liu369369/contest2026_443_fengxieke/hardware/fireeye_carrier_board_design.md

# 火眼 · 载板设计方案 v0.2

> 生成日期：2026-10-10 ｜ 修订：2026-10-11 ｜ 状态：设计输入已冻结，待评审
> 目标：为线下答辩提供一体化硬件载体（决赛打磨项）
> 关联：本文档只描述硬件；固件侧 INA228 驱动另见 `docs/`

### 修订记录

- **v0.8（2026-10-11）电源解耦完成 + R15 复原**：
  - 新增 `12V_IN` 网络：`DC 座(1脚) → U2 VIN / R9 EN上拉 / C10 输入电容`；
    `24V_P` 现在**只剩被测回路**（D1 阴极、R1 分流、R3 采样串阻）→ 板子自耗与测量彻底分离；
  - 12V 电池接口确定：**DC-005-5.5×2.1（即 DC5521）**，立创 **C9900017044**。
    注意：5.5×2.1 与 5.5×2.5 在立创库里**共用同一个封装**（`DC-IN-TH_DC-005-2`，footprintUuid 相同），
    所以板上焊盘一模一样、**PCB 不受影响**，区别只是塑料孔内径（2.1 / 2.5）——下单别买错；
    3 脚（开关脚）留空；
  - R15（19.1k，被误删）已复原并核验：`R15 1=GND 2=FB_NODE`；
  - 补充"上电前必须人工确认的 4 件事"，见 3.1 节末。
- **v0.7（2026-10-11）继电器改常开 + 补齐声光器件接线**：
  - 继电器由常闭改为**常开（NO）**：`COM(3) → NO(2) → LOAD_P`，NC 留空；**固件极性需反一次**；
  - 板载有源蜂鸣器 BUZZER1（TMB12A05，C96093）接线完成：1=5V、2=BUZZ_N；
  - 电源指示灯 LED1（5mm 翠绿，C52034719）+ U12（470Ω，C2907329）：VCC → U12 → LED1 → GND，常亮；
  - 外接报警灯模块座 U11（1×3，C54973828）：1=5V、2=GND、3=LED_CTRL；
  - 删除悬空的 R16（100k）。
- **v0.6（2026-10-11）按最新决定简化**：
  - **不加 3V3 LINK 跳线、不加保险丝**（用户决定）：载板 3.3V 直接经母座 JP6-2 给 START 板；
  - 网口按原接法保留（1=VCC 3.3V、2=5V、4=GND；6 条信号已接回主控）；
  - 继电器**维持常闭（NC）接法**，第 2 脚（NO）继续留空（失效安全讨论见 3.3，已知取舍）；
  - 蜂鸣器、报警 LED、绿色电源 LED 全部改为**板载**；删掉悬空的 R16。
- **v0.5（2026-10-11）按最新改动同步**：
  - 电池确认为**充放电双口**，充电口与放电口分开（无"带载充电"问题）；
  - W5500 座由 1×7 改为 **2×5（10 脚）**，补齐引脚定义，并把断开的 6 条信号网络接回主控；
  - 蜂鸣器、报警灯由"外接模块"改为**板载器件**（外壳需留声孔与灯孔）；
  - 记录继电器常闭/常开的失效安全讨论（见 3.3 待决策项）。
- **v0.4（2026-10-11）电源架构改为独立供电**：
  - 载板改用 **12V 锂电池**供电（DC 座进板 → 保险丝 → 防反接 → MP1584 → AMS1117），
    **24V 只作为被测回路**，与板子电源完全解耦；
  - 原「24V 自取电」方案作废（好处：板子自耗不进测量、可调电源电流显示与 INA228 读数一致）；
  - 主控供电采用 **3V3 LINK 跳线**：演示=载板供电（不插 USB），调试=插 USB 并拔跳线；
  - 补充电池充电、接口防呆、续航与安全口径，见 3.1 节。
- **v0.3（2026-10-11）按 EDA 网表复核结果修订**：
  - 新增 **6.5 节「母座引脚定义」**：从 START 板原理图逐脚实测出 JP5 / JP6 全部信号，
    并据此改正"JP5 侧有 GND 脚"这个错误说法（**JP5 的 38 脚全是 GPIO，没有任何电源脚**）；
  - 6.2 节 MP1584 补上第 9 脚（散热焊盘 EP）接 GND 的说明（原先误接 24V_P，已在 EDA 内改正）；
  - 3.1 节增加**待决策项**：载板 3.3V（网络名 VCC）与 START 板 3V3（JP6-2）并联的问题；
  - 9.3 节补上各接插件的立创编号（调试串口座实际是 **C18197979**，不是 C20363580）；
  - 原理图内已修复的缺陷（继电器驱动断线、23 组母座同号脚误连）记录在 `easyeda_progress.md`。
- **v0.2（2026-10-11）冲突清理**：
  - 地设计统一为**单一 GND**：删除 6.1 / 6.2 节的 GND_P / GND_S 分区写法，3.5 节相应改写；
  - 3.2 节功率路径补回漏画的 D1；
  - R_shunt 统一为 **2mΩ / 3W / 2512**（原写 2W）；
  - C1 / C2 统一为 **10µF / 50V**（原写 22µF/35V 与 22µF/16V）；
  - D1 统一为 **SS54 / SMA**（第 4 章原误写 SS34）；
  - 器件数由 Q1-Q3 改为 **Q1 / Q2**（报警灯直连，不用三极管）；
  - 蜂鸣器极性统一为**高电平导通**（原 3.3 节误写低电平触发）；
  - 注明 EDA 原理图中 3.3V 网络名为 `VCC`，与本文档的 `3V3` 是同一网络；
  - 6.4 节补充答辩口径提醒（1.75A 下的 ACS712 单码电流）。
  - **新增第十章「位号对照表」**：本文档位号与嘉立创 EDA 实际自动编号不一致，逐条列出对应关系
    （起因：EDA 网表复核发现 U1/U2/U3、R、C 的编号与本文档完全不同）。
- **v0.1（2026-10-10）**：初稿。

## 一、设计输入（冻结）

| 项 | 取值 | 备注 |
|---|---|---|
| MCU 子板 | GD32407V-START V1.1（板载 GD32F407VKT6） | 官方板，插在载板上 |
| 演示回路 | 24V DC / 1.75A | 可调电源 MN-605S + 灯泡假负载 |
| 断电机构 | 继电器 | 24V 低于触点 30VDC 额定 |
| 电流检测 | INA228 + 2mΩ 分流电阻 | 高端检测，共模 24V |
| 温度检测 | NTC 10K B3950 + 10k 分压 | 沿用现有方案 |
| 通信 | W5500 以太网 | 模块插接 |
| 显示 | SSD1306 OLED（I2C1） | 模块插接 |
| 载板供电 | **12V 锂电池 → DC 座 → MP1584(5V) → AMS1117(3.3V)** | 与 24V 被测回路完全独立 |
| 电池充电 | 电池另引 DC 母头到外壳外，用**配套的 12V 锂电充电器** | 充电回路不经过载板 |
| 外壳 | 挂壁式，3D 打印 | 已有打印机 |

## 二、机械定位（实测标定）

START 板外形 **60.0 x 95.0mm**。坐标以 START 板左上角为原点（x 向右、y 向下）。

| 项 | 数值 | 来源 |
|---|---|---|
| 板宽 x 板高 | 60.0 x 95.0mm | 实测 + 布局图标定（511px = 60mm） |
| JP6 母座中心线距左边缘 | 5.54mm | 塑壳外缘距板边 3mm + 塑壳半宽 2.54mm |
| JP6 两列焊盘中心线 | 距左边缘 4.27 / 6.81mm | 布局图像素测量 |
| JP5 母座中心线距右边缘 | 5.54mm | 与 JP6 对称 |
| 两母座中心距 | 48.92mm | 60 - 5.54 x 2 |
| 排针上端焊盘中心距板上边缘 | 30.0mm | 实测 2.9cm + 塑壳端偏移 1.27mm |
| 排针下端焊盘中心距板下边缘 | 19.3mm | 实测 1.8cm + 塑壳端偏移 1.27mm |
| 首末焊盘跨距 | 45.72mm | 18 x 2.54mm（自校验 30.0+45.72+19.3 = 95.0） |
| **第 1 脚方位** | **在排针下端** | 布局图丝印 PC7 = 第 38 脚，位于最上端 |

> 第 1 脚方位如果搞反，母座会整体反向 180 度，所有信号错位。已用布局图丝印交叉确认。

## 三、电路方案

### 3.1 电源树

> **2026-10-11 决策：载板独立供电。** 板子用 12V 锂电池供电，24V 只当被测回路。
> 好处是板子自耗完全不经过分流电阻，可调电源显示的电流与 INA228 读数一致（不必再解释几十 mA 自耗）。

```
【板子电源，与下面完全独立】
12V 锂电 → DC 座 J3 →（D4 防反接，可选）→ U1 MP1584EN (12V→5V)
                                                  ├─ 继电器线圈 / 蜂鸣器 / 报警灯（5V）
                                                  └─ U2 AMS1117-3.3 (5V→3.3V)
                                                        ├─ INA228 / OLED / W5500 / I2C 上拉
                                                        └─ 母座 JP6-2（经 3V3 LINK 跳线）→ START 板 3V3

【被测回路】
24V 端子 J1 → F1 → D1 → R1(2mΩ) → 继电器 COM→NC → J2 → 负载 → 回 GND
```

- 12V 输入对 MP1584（4.5-28V）**余量充足**，不再是 24V 那种贴着上限的状态。
- **主控供电（2026-10-11 决定：不加跳线）**：载板 3.3V 直接经母座 JP6-2 送到 START 板 3V3。
  - **演示**：只给 12V 电池，不插 USB。
  - **调试**：插 USB 时把 12V 电池的 DC 座拔掉 —— START 板的 LDO 会顺带把载板 3.3V 反灌供起来，
    逻辑（INA228 / OLED / 网口）能跑；但 5V 那一路没有，**继电器不吸合、蜂鸣器和灯不动作**，
    要测声光报警还是得给 12V。
  - 已知取舍：**12V 电池和 USB 同时插时，两片 AMS1117 输出对顶**（还可能顺着 START 板 LDO 往 USB 的 VBUS 倒灌）。
    现场别这么用；真要同时用，就回到"加跳线"的方案。
- 载板经 JP6-2 给 START 板供电时，还要带上板载 GD-Link（GD32F103，约 20~30mA）；
  AMS1117（1A）与 MP1584（3A）都绰绰有余。
- 外设一律走载板自供电：START 板 3V3 那条路受板上 500mA 自恢复保险丝限制，不要在它上面挂外设。
- **电池与充电（安全底线）**：（电池为**充放电双口**，2026-10-11 确认，充电口与放电口分开）
  - 12V 锂电必须用**配套的专用充电器**充（3S 锂离子满电 12.6V，12V LiFePO4 满电 14.6V），
    **绝对不能用普通 12V 电源适配器直接充**——本作品要防的就是过充，方案里不能自己踩这个坑。
  - 充电口（DC 母头）装在外壳外面，充电回路**不经过载板**。
  - **保险丝按 2026-10-11 决定不加**：依赖电池包自带 BMS 的短路保护。若后面想补，电池正极就近串一个
    0.5~1A 自恢复保险丝即可（PCB 上留两个焊盘位置更省事）。
  - 续航估算：载板+主控约 160mA@12V（继电器常励磁占大头），3Ah 的 12V 包约能撑 18 小时，答辩够用。
  - 建议同时准备一个 12V 适配器当现场备用（接口与充电口区分开，别混插）。
- 原「24V 自取电」方案作废（历史记录保留在 v0.2/v0.3 的修订说明里）。

**上电前必须人工确认的 4 件事**（板上没有提示，靠万用表和模块丝印）：

1. **DC 座极性**：万用表通断档，一支表笔插进座的中心孔，另一支分别碰 1 / 2 / 3 脚焊盘，
   确认哪个焊盘是中心针。现按 `1 脚 = 12V_IN`、`2 脚 = GND` 接；**3 脚是开关脚，留空，不要接地**
   （把开关脚接地，没插插头时会把正负极短起来）。
2. **网口模块**：现在 1 脚(3.3V) 和 2 脚(5V) 都接了。确认模块是不是"5V 进、自带 LDO"的版本——
   如果是，建议把 1 脚断开，否则模块自己的 LDO 与载板 3.3V 会对顶。
3. **报警灯模块座 U11（1×3）**：现接 `1=GND、2=5V、3=LED_CTRL`，按模块丝印核对顺序。
4. **蜂鸣器极性**：现接 `1=5V、2=BUZZ_N`；若实物 "+" 在另一脚，两根线对调即可（接反只会不响，不烧）。

### 3.2 电流检测（INA228）

| 元件 | 参数 | 说明 |
|---|---|---|
| R_shunt | 2mΩ / 3W / 2512 | 5A 时压降 10mV、耗散 50mW（实物 LMN25HF3P0R002S，C41406285） |
| U3 | INA228AIDGSR（VSSOP-10） | 85V 共模，20 位 ΔΣ |
| 输入滤波 | 2 x 10Ω + 100nF 差分 + 10nF 对地 | 截止约 160kHz |
| I2C 上拉 | 4.7kΩ x 2 -> 3.3V | 与 OLED 共用 I2C1，不冲突 |
| 地址 | A0/A1 接地 | 0x40（OLED 0x3C） |
| ADC 量程 | VSHUNT = ±40.96mV | 对应 ±20.5A，LSB 约 0.039mA |

**功率路径**（分流电阻放在最前，共模恒定）：

```
J1(24V+) -> F1 -> D1 -> R_shunt -> K1(COM->NC) -> J2(负载+) -> 负载 -> J2(负载-) -> 电源 -
```

分流电阻紧贴电源侧，即使继电器断开，INA228 的共模也稳定在 24V。

### 3.3 断电与输出驱动

| 通道 | 器件 | 驱动方式 | 极性 |
|---|---|---|---|
| 继电器 K1 | 5V 线圈，1 组转换（等效 JQC-3FF-S-Z） | NPN S8050 + 1kΩ 基极 + 10kΩ 下拉 + 1N4148 续流 | 高电平吸合（**需重新定标**） |
| 蜂鸣器 | 有源蜂鸣器 | NPN S8050 + 1kΩ 基极 + 10kΩ 下拉 | **高电平导通**（改为低边驱动，与原方案相反，宏需反转） |
| 报警灯 | LED 模块信号脚（模块自带驱动） | 直连排针，不加三极管 | 高电平触发（沿用） |

> **重要**：由"裸器件直连"改为"三极管驱动"会改变触发极性。固件中的
> `FIREEYE_RELAY_ACTIVE_LOW`、`FIREEYE_BUZZER_ACTIVE_HIGH`、`FIREEYE_LED_ACTIVE_HIGH`
> 三个宏必须上板实测后重新定标，不可沿用旧值。

> **已决定（2026-10-11）：继电器改用常开（NO）接法**（原为常闭，按保护逻辑改过来）。
> 接法为 `COM(3) → NO(2) → LOAD_P`，NC(5) 留空：**励磁才导通；掉电、复位、报警都会自动断开负载**。
> - 这才是保护类设备真正意义上的"失效安全"：板子死机或断电时负载被切断。
> - **固件极性要反一次**：原先是"报警→吸合（断开）"，现在是"正常→吸合（导通）、报警→释放（断开）"。
>   应用层的 `gd32_fireeye_set_relay(true/false)` 语义不变（`true`=断开负载、`false`=恢复），
>   只需要把**板级实现里的 GPIO 电平映射反过来**。
> - 正常充电时线圈常励磁 71mA（耗电与之前报警后相同），报警后线圈释放、反而更省电。

### 3.4 接口定义

| 接口 | 形式 | 信号 |
|---|---|---|
| START 板母座 | 2 x (2x19) 母座，2.54mm | JP5 / JP6 全引出 |
| 24V 输入 | 2 位螺丝端子 5.08mm | 电源进 |
| 负载输出 | 2 位螺丝端子 5.08mm | 24V 回路出 |
| OLED | 4 pin 排针 | GND / 3V3 / SCL(PB10) / SDA(PB11) |
| W5500 | **2×5（10 脚）排针座** | 1=VCC(3.3V)、2=5V、3=MISO、4=GND、5=MOSI、6=RST、7=SCS、8=INT、9=SCLK、10=NC（2026-10-11 决定：按现状保留） |
| 温度 | 2 pin 端子 | NTC 分压中点 -> PA6 |
| 调试串口 | 3 pin 排针 | PB6(TX) / PB7(RX) / GND |

> 母座 JP5 / JP6 的**逐脚定义**见 6.5 节（实测自 START 板原理图）。

### 3.5 采样抗干扰（解决电流检测偏差的关键）

原实测问题：继电器线圈 70mA 与传感器共用供/地路径，产生约 1.12A 的假底数（改线后残留 0.12A）。

载板对策（**最终版本见第八章 8.5，本节只列结论**）：

1. **单一地**：全板只用**一个 GND 网络**，不做 GND_P / GND_S 分割（理由见第八章）；
2. **开尔文接法**：INA228 的 IN+/IN- 从分流电阻焊盘内侧取样，走等长差分对；
3. **回流路径在布局层面分离**：继电器线圈、蜂鸣器、报警灯的回流走板下区，不横穿采样区、不与差分对平行；
4. **功率与信号分区**：24V/2A 大电流路径走板的一侧，信号走另一侧，中间用地铜隔离。

## 四、BOM 概览

| 位号 | 器件 | 封装 | 数量 | 参考价 |
|---|---|---|---|---|
| U1 | MP1584EN（商城件 C2916141 标注 MP1584WN） | ESOP-8 | 1 | 2 元 |
| U2 | AMS1117-3.3 | SOT-223 | 1 | 0.3 元 |
| U3 | INA228AIDGSR | VSSOP-10 | 1 | 20 元 |
| R_shunt | 2mΩ 3W | 2512 | 1 | 1 元 |
| K1 | 继电器 5V | DIP | 1 | 3 元 |
| Q1/Q2 | S8050 | SOT-23 | 2 | 0.3 元 |
| F1 | 自恢复保险丝 2A | 1812 | 1 | 0.5 元 |
| D1 | SS54 | SMA | 1 | 0.3 元 |
| J1/J2 | 螺丝端子 5.08mm | THT | 2 | 2 元 |
| — | 2x19 母座 2.54mm | THT | 2 | 2 元 |

## 五、已确认项（2026-10-10）

1. ACS712 对比接口：**不留**
2. 万用表：现有三位半（实验方案见 6.4）
3. 继电器：**板载直插**
4. 连接方式：START 板**直接插在载板上**（插接式）
5. 外壳内部布局与开孔朝向：待定

## 六、网表级连接表

> 说明：IC 的引脚号请以厂商 datasheet 为准，下表按**信号名**连接。
> 本章位号是本文档自定义编号，与 EDA 实际位号不同，对照表见第十章。

### 6.1 网络定义

| 网络 | 类别 | 说明 |
|---|---|---|
| 24V_IN | 功率 | 端子 J1-1 出来、保险丝之前 |
| 24V_F | 功率 | 保险丝之后、防反接之前 |
| 24V_P | 功率 | 防反接之后（保护后） |
| 24V_SW | 功率 | 分流电阻之后、继电器 COM 之前 |
| LOAD_P | 功率 | 继电器 NC 之后、去负载端子 |
| GND | 地 | **全板单一地网络**：负载回流、继电器/蜂鸣器/报警灯回流与 INA228、MCU、I2C、OLED、W5500、LDO 共用（最终决定见第八章） |
| 5V | 电源 | DC-DC 输出 |
| 3V3 | 电源 | LDO 输出（**EDA 原理图中该网络名为 `VCC`**，两者是同一网络） |

> **本节早先的 GND_P / GND_S 分区写法已作废**：本章其余条目里出现的 GND_P / GND_S 一律按 GND 理解。
> 改为单一地的理由见第八章开头；继电器线圈的 70mA 靠**布局避让**隔离（8.5 第 9 条），而不是靠分割地。

### 6.2 元件连接

**J1（24V 输入端子，2P）**
- 1 -> 24V_IN
- 2 -> GND（负载回流与信号地的唯一汇合点，全板地参考点）

**F1（自恢复保险丝 2A）**
- 1 -> 24V_IN
- 2 -> 24V_F

**D1（防反接 SS54）**
- 阳极 -> 24V_F
- 阴极 -> 24V_P
- 压降约 0.45V@2A，位于分流电阻之前，不影响电流测量

**R1（分流电阻 2mΩ / 3W / 2512）**
- 1 -> 24V_P
- 2 -> 24V_SW
- 开尔文取样：INA228 的 IN+ 从 R1-1 内侧取、IN- 从 R1-2 内侧取

**K1（5V 继电器，板载直插）**
- 线圈+ -> 5V
- 线圈- -> Q1 集电极
- COM -> 24V_SW
- NO -> LOAD_P（励磁才导通；报警/掉电/复位即断开）
- NC -> 悬空（未使用）

**J2（负载输出端子，2P）**
- 1 -> LOAD_P
- 2 -> GND

**U1（MP1584EN，24V -> 5V）**
- IN -> 24V_P
- EN -> 100kΩ 上拉到 IN
- BST -> 100nF -> SW
- SW -> L1 47µH -> 5V；SS34 续流二极管（阴极接 SW、阳极接 GND）
- FB -> 分压 R_fb1 = 100kΩ（FB 到 5V）/ R_fb2 = 19.1kΩ（FB 到 GND），约 5.0V
- COMP -> 3.3nF + 6.8kΩ 串联到 GND
- FREQ -> 100kΩ 到 GND（约 500kHz）
- GND -> GND
- **第 9 脚（散热焊盘 EP）-> GND**：立创库符号把第 9 脚标成 `EN`，但封装实际是 `SOIC-8-EP`，
  按 datasheet 散热焊盘应接 GND（原先误接 24V_P，已在 EDA 内改正）

**U2（AMS1117-3.3）**
- IN -> 5V（10µF 到 GND）
- OUT -> 3V3（10µF 到 GND）
- GND -> GND

**U3（INA228）**
- VS -> 3V3
- GND -> GND
- IN+ -> R1-1（串 10Ω）
- IN- -> R1-2（串 10Ω）
- 差分滤波：100nF 跨 IN+/IN-，10nF 分别对 GND
- VBUS -> 24V_SW（顺带测供电电压）
- SCL -> I2C1_SCL
- SDA -> I2C1_SDA
- A0 / A1 -> GND（地址 0x40）
- ALERT -> 悬空
- 上拉：I2C1_SCL、I2C1_SDA 各 4.7kΩ 到 3V3

**Q1（继电器驱动，S8050）**
- 基极 -> 1kΩ -> START-PB0
- 基极 -> 10kΩ 下拉到 GND
- 发射极 -> GND
- 集电极 -> K1 线圈-
- D2（1N4148）跨线圈：阴极接 5V、阳极接 Q1 集电极
- 极性：PB0 高电平吸合（与原方案一致）

**Q2（蜂鸣器驱动，S8050）**
- 基极 -> 1kΩ -> START-PB1
- 基极 -> 10kΩ 下拉到 GND
- 发射极 -> GND
- 集电极 -> 蜂鸣器-
- 蜂鸣器+ -> 5V
- 极性：PB1 高电平导通（**与原方案相反，宏需反转**）

**报警灯（3 pin 排针，直连不加驱动）**
- VCC -> 5V
- GND -> GND
- SIG -> START-PD9
- 极性：保持不变（原模块即为高电平触发）

**NTC 分压**
- 3V3 -> 10kΩ -> 节点 -> NTC -> GND
- 节点 -> START-PA6
- 节点可加 100nF 到 GND 去抖

**OLED 座（4 pin，顺序以实际模块丝印为准）**
- GND -> GND
- VCC -> 3V3
- SCL -> I2C1_SCL（START-PB10）
- SDA -> I2C1_SDA（START-PB11）

**W5500 座**
- SCLK -> START-PB13
- MISO -> START-PB14
- MOSI -> START-PB15
- SCS -> START-PE7
- RST -> START-PE9
- INT -> START-PE11
- 3V3 -> 3V3
- GND -> GND

**调试串口（3 pin）**
- TX -> START-PB6
- RX -> START-PB7
- GND -> GND

**START 板母座（2 x 2x19）**
- 仅连接上表用到的引脚，其余悬空
- 机械定位见第二章

### 6.3 固件需要同步的改动

| 项 | 原值 | 载板上的新值 |
|---|---|---|
| FIREEYE_RELAY_ACTIVE_LOW | 0 | **要反一次**（改用 NO 后：报警时继电器释放；具体填 0 还是 1 按该宏在代码里的定义确认） |
| FIREEYE_BUZZER_ACTIVE_HIGH | 0 | **1**（NPN 低边驱动改为高电平有效） |
| FIREEYE_LED_ACTIVE_HIGH | 1 | 1（不变） |
| 电流读取 | ADC 采 PA4 | **INA228 走 I2C1（需新写驱动）** |
| 温度读取 | ADC 采 PA6 | 不变 |

> 三个极性宏的最终值必须**上板实测**后确认，不要照抄此表。

### 6.4 精度实验方案（三位半万用表的限制）

三位半万用表直流电流档典型精度为 ±(1.0%+2 字)、2A 档分辨率 1mA，
而 INA228 的目标精度优于 ±0.5%。**拿它当标定基准是非对称的，不做绝对精度对比。**

改用两条可执行的路线：

1. **读数抖动对比**（主推，不需要外部标准）：同一电流工况下各采 60 秒，
   分别统计旧方案（ACS712）与新方案（INA228）读数的标准差与峰峰值，
   结论写成"读数波动从 ±xx mA 降到 ±x mA"。这是自比较，不受万用表精度影响。
2. **量级核对**（辅助）：用万用表确认电流大致在设定值附近（如设定 1.75A、实测 1.7~1.8A），
   只用于证明"量级正确"，不声明精度。

如果后续能借到四位半万用表，再补做"设定值 vs 读数"的线性度曲线。

> **答辩口径提醒**：旧方案"读数只有 6~7 个 ADC 码"的论证基于 **0.15A** 的老负载；
> 现在演示电流是 **24V / 1.75A**，同样条件下 ACS712 有约 71 个码。答辩时不要沿用"6~7 个码"的说法，
> 统一按 1.75A 口径：ACS712 单码 ≈ 24mA，INA228 单码 ≈ 0.039mA（约 625 倍差距）。
> 造成旧方案"实测 1.12A 假底数"的地线耦合问题与负载大小无关，这条论据可以继续用。

### 6.5 母座引脚定义（实测自 START 板原理图）

来源：`GD32F470V-START-V1.0.pdf` 第 1 页（Extension），按图纸坐标逐脚取出，非推测。

**JP6（EDA 位号 U5）**：1 脚、3 脚 = GND，2 脚 = +3V3，其余 35 脚为 GPIO。

| 脚 | 信号 | 脚 | 信号 | 脚 | 信号 | 脚 | 信号 |
|---|---|---|---|---|---|---|---|
| 1 | GND | 11 | PB9 | 21 | PD4 | 31 | PA14 |
| 2 | +3V3 | 12 | PE0 | 22 | PD5 | 32 | PA13 |
| 3 | GND | 13 | PB7 | 23 | PD3 | 33 | PA10 |
| 4 | PC13 | 14 | PB8 | 24 | PD2 | 34 | PA9 |
| 5 | PE5 | 15 | PB5 | 25 | PD1 | 35 | PA8 |
| 6 | PE6 | 16 | PB6 | 26 | PD0 | 36 | PC9 |
| 7 | PE3 | 17 | PB3 | 27 | PC12 | 37 | PC8 |
| 8 | PE4 | 18 | PB4 | 28 | PC11 | 38 | PC7 |
| 9 | PE1 | 19 | PD6 | 29 | PC10 | | |
| 10 | PE2 | 20 | PD7 | 30 | PA15 | | |

**JP5（EDA 位号 U6）**：38 脚**全部是 GPIO，没有任何 GND / 3V3 脚**。

| 脚 | 信号 | 脚 | 信号 | 脚 | 信号 | 脚 | 信号 |
|---|---|---|---|---|---|---|---|
| 1 | PC1 | 11 | PC4 | 21 | PE13 | 31 | PD9 |
| 2 | PC0 | 12 | PA7 | 22 | PE12 | 32 | PD8 |
| 3 | PC3 | 13 | PB0 | 23 | PE15 | 33 | PD11 |
| 4 | PC2 | 14 | PC5 | 24 | PE14 | 34 | PD10 |
| 5 | PA2 | 15 | PE7 | 25 | PB11 | 35 | PD13 |
| 6 | PA1 | 16 | PB1 | 26 | PB10 | 36 | PD12 |
| 7 | PA4 | 17 | PE9 | 27 | PB13 | 37 | PD15 |
| 8 | PA3 | 18 | PE8 | 28 | PB12 | 38 | PD14 |
| 9 | PA6 | 19 | PE11 | 29 | PB15 | | |
| 10 | PA5 | 20 | PE10 | 30 | PB14 | | |

**载板用到的 JP5 脚（逐条与信号名核对一致）**

| 脚 | 信号 | 载板网络 | 脚 | 信号 | 载板网络 |
|---|---|---|---|---|---|
| 9 | PA6 | NTC_ADC | 25 | PB11 | I2C1_SDA |
| 13 | PB0 | RELAY_CTRL | 26 | PB10 | I2C1_SCL |
| 15 | PE7 | W5500_SCS | 27 | PB13 | SPI1_SCK |
| 16 | PB1 | BUZZ_CTRL | 29 | PB15 | SPI1_MOSI |
| 17 | PE9 | W5500_RST | 30 | PB14 | SPI1_MISO |
| 19 | PE11 | W5500_INT | 31 | PD9 | LED_CTRL |

**载板用到的 JP6 脚**：1 / 3 = GND，2 = +3V3（**注意 3.1 节的待决策项**），13 = PB7 = UART_RX，16 = PB6 = UART_TX。

> **踩坑记录**：JP5 的 PD9/PD8/PD11/PD10/PD13/PD12/PD15/PD14 与 JP6 的 PA13/PA14（SWD 调试口）等脚
> **物理脚号相同**。早期在 EDA 里把脚号直接当网络标签用，结果 JP5 与 JP6 的同号脚被连成 23 个网络
> （其中一对是 PA13=SWDIO），已于 2026-10-11 改名为 `JP5_n` / `JP6_n` 消除。

## 七、载板布局（v0.3）

### 7.1 尺寸与模块实测

| 对象 | 尺寸 | 备注 |
|---|---|---|
| 载板 | **105 x 140mm** | 用户确定 |
| START 板 | 60 x 95mm | GD32407V-START V1.1 |
| W5500 模块 | 28 x 55mm | 含 RJ45 座，7 pin 排针 |
| OLED 模块 | 26.92 x 27.35mm | 安装孔距 23.34 x 23.81mm，孔径 2.5mm |

### 7.2 分区

坐标原点为载板左上角，x 向右、y 向下。

| 区 | 范围 | 内容 |
|---|---|---|
| 左区 | x 0-40mm | 上：OLED 座（y 14-41）；下：W5500 座（y 85-140，RJ45 朝下、模块下端与载板下边缘齐平，网线从板下方出） |
| 右区 | x 40-100mm, y 10-105mm | START 板覆盖区。板下净空约 8.5mm，只放贴片元件（DC-DC / LDO / 三极管驱动） |
| 下区 | y 105-140mm | 功率路径集中区：J1、F1、D1、R_shunt、INA228、继电器 K1、J2 |
| 边距 | 四周约 5mm | 板框、安装孔、丝印 |

功率路径集中在下方一横条，J1 -> 分流 -> 继电器 -> J2 的走线最短，便于做星形接地。

### 7.3 母座定位（载板坐标）

START 板左上角位于载板 (40, 10)。

| 项 | 坐标 |
|---|---|
| JP6 两列焊盘中心线 | x = 44.27 / 46.81mm |
| JP5 两列焊盘中心线 | x = 93.19 / 95.73mm |
| 两母座中心距 | 48.92mm |
| 第 38 脚（排针上端）焊盘中心 | y = 40.0mm |
| 第 1 脚（排针下端）焊盘中心 | y = 85.72mm |
| 首末焊盘跨距 | 45.72mm（18 x 2.54） |

> **第 1 脚在下端**。母座引脚号必须从下往上数，装反则全部信号错位。

### 7.4 布局说明与待定

- 下区（y 105-140）放 J1、J2、继电器、R_shunt + INA228，x 方向从 36mm 起，避开 W5500 的 RJ45 出线路径；
  DC-DC、LDO、三极管驱动全部放在 START 板下方的贴片区（虚线框 x 45-95, y 45-100）。
- W5500 现按 **RJ45 朝下** 设计。若改为朝左出线，左区需加宽到 55mm，载板宽改为 120mm。
- START 板四角固定方式（铜柱 + 螺丝，需在载板打对应安装孔）待定。

## 八、网表（按网络索引，最终版）

> **读表前必看**：本章及第九章的位号（U1/U2/U3、R1-R15、C1-C11、K1、L1、J1/J2、JP5/JP6）
> 是本文档自定义的编号；**嘉立创 EDA 里实际是另一套自动编号**。
> 两套编号的对照表见第十章，PCB / 贴片 / 飞线一律以 EDA 的位号为准。

> **地设计的最终决定：采用单一 GND 网络。**
> 理由：更换 INA228 后电流测量为差分输入 + 数字输出，CMRR 高于 100dB，
> 地线压降经开尔文连接后不进入测量结果。前文 6.1/6.2 中的 GND_P / GND_S 统一并入 GND。
> 抗干扰的重点因此从"分区接地"转移到"开尔文连接 + 布局避让"，见 8.5。

### 8.1 元件编号约定

| 位号 | 器件 | 位号 | 器件 |
|---|---|---|---|
| J1 | 24V 输入端子 | J2 | 负载输出端子 |
| F1 | 自恢复保险丝 | K1 | 继电器（5V 线圈） |
| D1 | 防反接 SS54 | D2 | 线圈续流 1N4148 |
| D3 | DC-DC 续流 SS34 | L1 | 47µH 功率电感 |
| U1 | MP1584EN | U2 | AMS1117-3.3 |
| U3 | INA228 | Q1/Q2 | S8050 |
| R1 | 分流电阻 2mΩ/3W | R2/R3 | INA228 输入串阻 10Ω |
| R4/R5 | I2C 上拉 4.7kΩ | R6/R7 | 继电器基极 1kΩ / 下拉 10kΩ |
| R8/R9 | 蜂鸣器基极 1kΩ / 下拉 10kΩ | R10 | NTC 分压 10kΩ |
| R11/R12 | FB 分压 100kΩ / 19.1kΩ | R13/R14 | COMP 6.8kΩ / FREQ 100kΩ |
| R15 | EN 上拉 100kΩ | C1/C2 | 输入 / 输出各 10µF/50V（无极性陶瓷） |
| C3 | 差分滤波 100nF | C4/C5 | 共模 10nF |
| C6 | INA228 去耦 100nF | C7/C8 | LDO 输入/输出 10µF |
| C9 | BST 100nF | C10 | COMP 3.3nF |
| C11 | NTC 滤波 100nF | | |

### 8.2 功率与电源网络

| 网络 | 连接点 |
|---|---|
| 24V_IN | J1-1, F1-1 |
| 24V_F | F1-2, D1-A |
| 12V_IN | DC 座-1, U1-IN, R15-1, C1(+)（12V 电池进板，与 24V 回路无关） |
| 24V_P | D1-K, R1-1, R3-1（**只含被测回路**，板子自耗已移出） |
| 24V_SW | R1-2, K1-COM, U3-VBUS |
| LOAD_P | K1-NC, J2-1 |
| 5V | L1-2, C2(+), U2-IN, C7(+), K1 线圈+, 蜂鸣器+, 报警灯 VCC, R11-2, U1-FB 分压上端 |
| 3V3 | U2-OUT, C8(+), U3-VS, C6-1, OLED-VCC, W5500-3V3, R4-2, R5-2, R10-1（**EDA 原理图中该网络名为 VCC**） |
| GND | J1-2, J2-2, C1(-), C2(-), D3-A, U1-GND, R12-2, R14-2, C10(经 R13), U2-GND, C7(-), C8(-), U3-GND, C4-2, C5-2, C6-2, Q1-E, Q2-E, 报警灯 GND, OLED-GND, W5500-GND, 串口 GND, NTC 下端, R7-2, R9-2, 母座 JP6(U5)-1 与 JP6(U5)-3（**JP5 侧没有任何 GND 脚**，见 6.5） |

**DC-DC 外围（U1 / MP1584EN，24V -> 5V）**

| 网络 | 连接点 |
|---|---|
| U1-BST | C9-1 |
| U1-SW | C9-2, L1-1, D3-K |
| D3-A | GND |
| U1-FB | R11-1, R12-1 |
| U1-COMP | C10-1（C10-2 -> R13-1，R13-2 -> GND） |
| U1-FREQ | R14-1（R14-2 -> GND） |
| U1-EN | R15-1（R15-2 -> 24V_P） |
| U1-IN | C1(+)，C1(-) -> GND |

> **C1 / C2 说明**：实物件是 10µF/50V 1206 陶瓷电容（**无极性**），表中 C1(+) / C1(-) 、C2(+) / C2(-)
> 只表示"接 24V_P 的一端 / 接 GND 的一端"，不是电解电容的极性标记。

### 8.3 电流检测网络（INA228）

| 网络 | 连接点 |
|---|---|
| INA_INP | R1-1, R2-1 |
| INA_INM | R1-2, R3-1 |
| INA_INP_F | R2-2, U3-IN+, C3-1, C4-1 |
| INA_INM_F | R3-2, U3-IN-, C3-2, C5-1 |
| C4-2 / C5-2 | GND |
| U3-VBUS | 24V_SW |
| U3-SCL | I2C1_SCL |
| U3-SDA | I2C1_SDA |
| U3-A0 / U3-A1 | GND（地址 0x40） |
| U3-ALERT | 悬空 |
| U3-VS | 3V3（就近 100nF + 1µF 到 GND） |

### 8.4 驱动、通信与外设

| 网络 | 连接点 |
|---|---|
| RELAY_CTRL | 母座 PB0 脚（JP5-13）, R6-1 |
| RELAY_DRV | R6-2, Q1-B, R7-1 |
| RELAY_COIL_N | Q1-C, K1 线圈-, D2-A |
| D2-K | 5V |
| BUZZ_CTRL | 母座 PB1 脚（JP5-16）, R8-1 |
| BUZZ_DRV | R8-2, Q2-B, R9-1 |
| BUZZ_N | Q2-C, BUZZER1-2（板载有源蜂鸣器 TMB12A05，正极接 5V） |
| LED_CTRL | 母座 PD9 脚（JP5-31）, U11-3（外接报警灯模块 SIG） |
| $1N239（内部网络） | U12-2, LED1-1 —— 电源指示灯支路中间点，仅这两点相连 |
| NTC_ADC | 母座 PA6 脚（JP5-9）, R10-2, NTC 上端, C11-1 |
| C11-2 | GND |
| I2C1_SCL | 母座 PB10 脚（JP5-26）, OLED-SCL, U3-SCL, R4-1 |
| I2C1_SDA | 母座 PB11 脚（JP5-25）, OLED-SDA, U3-SDA, R5-1 |
| SPI1_SCK | 母座 PB13 脚（JP5-27）, W5500-SCLK |
| SPI1_MISO | 母座 PB14 脚（JP5-30）, W5500-MISO |
| SPI1_MOSI | 母座 PB15 脚（JP5-29）, W5500-MOSI |
| W5500_SCS | 母座 PE7 脚（JP5-15）, W5500-SCS |
| W5500_RST | 母座 PE9 脚（JP5-17）, W5500-RST |
| W5500_INT | 母座 PE11 脚（JP5-19）, W5500-INT |
| UART_TX | 母座 PB6 脚（JP6-16）, 调试串口 TX |
| UART_RX | 母座 PB7 脚（JP6-13）, 调试串口 RX |

### 8.5 抗干扰设计要点

**采样链路（最关键）**

1. **开尔文连接**：R2 / R3 从 R1 的焊盘**内侧**引出，不借用功率走线；这是消除走线电阻误差的根本手段。
2. **差分对**：INA_INP / INA_INM 两条线等长、平行、间距固定、面积最小；中途不换层、不打过孔（必须换层时两条线一起换）。
3. **滤波就近**：C3（100nF 差分）与 C4/C5（10nF 共模）紧贴 U3 的输入脚，走线总长控制在 10mm 内。
4. **避让**：差分对与 SW 节点、L1、继电器线圈回路的间距不小于 5mm，且不平行走线。

**开关电源**

5. **SW 节点面积最小化**：这是最强的辐射源，铜箔面积越小越好，且不引长线。
6. **紧贴布局**：C1 贴 U1-IN、L1 与 C2 贴 U1-SW，回路面积最小。
7. **远离敏感区**：L1 与 U3、NTC 分压、I2C 走线的距离尽量远。

**继电器与感性负载**

8. **续流二极管紧贴线圈**：D2 到线圈两端的走线尽量短，抑制断开瞬间的反向尖峰。
9. **线圈回流路径**：5V -> 线圈 -> Q1 -> GND 这条回路走板下区，**不穿过采样区**，也不与差分对平行。
10. **可选 RC 吸收**：若断开时仍有尖峰影响，可在线圈两端并联 100Ω + 100nF。

**通信与数字**

11. **I2C**：4.7kΩ 上拉；走线远离 SW 与线圈；若有振铃可串 33Ω。
12. **SPI**：W5500 的四条线走短线，不跨分割区，不与差分对平行；必要时串 22-33Ω。
13. **去耦**：每个 IC 的电源脚就近放 100nF；U1 输入 10µF + 100nF；U2 输入/输出各 10µF。

**结构与外壳**

14. OLED 与 RJ45 的排线在载板边缘就近引出，避免长距离绕行；OLED 的 I2C 排线远离功率走线。
15. 功率区（下区）与信号区（左区、板下贴片区）在各层做物理分隔。

## 九、元件清单与封装（画图用）

> 用于在嘉立创 EDA 中放元件。封装按贴片优先（载板下方净空 8.5mm，贴片更稳妥）。
> 型号为常见市售型号，具体以下单时商城库存为准。
> 各器件的立创商城编号（C 开头）见 `easyeda_progress.md` 的已放置元件表。

### 9.1 有源器件

| 位号 | 器件 | 参数 | 封装 | 常见型号 | 数量 |
|---|---|---|---|---|---|
| U1 | 降压 DC-DC | 24V -> 5V / 3A | ESOP-8 | MP1584EN（C2916141，商城标注 MP1584WN） | 1 |
| U2 | LDO | 5V -> 3.3V / 1A | SOT-223 | AMS1117-3.3 | 1 |
| U3 | 电流/电压监测 | 20 位 ΔΣ，I2C | VSSOP-10 | INA228AIDGSR | 1 |
| Q1 | NPN 三极管 | 继电器驱动 | SOT-23 | S8050 | 1 |
| Q2 | NPN 三极管 | 蜂鸣器驱动 | SOT-23 | S8050 | 1 |
| D1 | 肖特基 | 防反接 5A/40V | SMA | SS54（C22452） | 1 |
| D2 | 开关二极管 | 线圈续流 | SOD-123 | 1N4148 | 1 |
| D3 | 肖特基 | DC-DC 续流 3A/40V | SMA | SS34 | 1 |
| K1 | 继电器 | 5V 线圈，1 组转换 | DIP（直插） | SRD-05VDC-SL-C / JQC-3FF-S-Z | 1 |
| F1 | 自恢复保险丝 | 2A | 1812 | 1812L200/36GR（C49196649） | 1 |

### 9.2 无源器件

| 位号 | 参数 | 封装 | 数量 |
|---|---|---|---|
| R1 | 2mΩ / 3W 合金电阻 | 2512 | 1 |
| R2, R3 | 10Ω | 0603 | 2 |
| R4, R5 | 4.7kΩ | 0603 | 2 |
| R6, R8 | 1kΩ | 0603 | 2 |
| R7, R9, R10 | 10kΩ | 0603 | 3 |
| R11, R14, R15 | 100kΩ | 0603 | 3 |
| R12 | 19.1kΩ | 0603 | 1 |
| R13 | 6.8kΩ | 0603 | 1 |
| C1 | 10µF / 50V（**耐压必须 ≥35V**） | 1206 | 1 |
| C2 | 10µF / 50V | 1206 | 1 |
| C3, C6, C9, C11 | 100nF | 0603 | 4 |
| C4, C5 | 10nF | 0603 | 2 |
| C7, C8 | 10µF / 16V | 0805 | 2 |
| C10 | 3.3nF | 0603 | 1 |
| L1 | 47µH 功率电感 | CD54 或 CDRH | 1 |
| NTC | 10K B3950 | 直插或贴片 | 1 |

### 9.3 接插件

| 本文档位号 | EDA 位号 | 器件与立创编号 | 备注 |
|---|---|---|---|
| J1 | U7 | 24V 输入端子 KF128-5.08-2P-AA（C474952） | 与 J2 同侧 |
| J2 | U8 | 负载输出端子 KF128-5.08-2P-AA（C474952） | |
| — | U5 / U6 | START 板母座 KH-2.54FH-2X19P-H5.0（C55160397） | 定位见 7.3 |
| — | H1 | OLED 座 1×4 弯插排针 PZ254-1-04-W-8.5（C3012225） | 顺序以模块丝印为准 |
| — | U9 | W5500 座 **2×5 直插排针** LAIL-PM2.54-5PX2-L | 1/3/5/7/9 在左列、2/4/6/8/10 在右列；RJ45 朝板下边缘 |
| — | U10 | 调试串口 1×3 弯插排针 PZ254-1-03-W-2.5-G1（**C18197979**） | TX / RX / GND |
| — | H2 | NTC 接口 1×2 直插排针 HX PZ-254-1-02-Z-11.5（C42391536） | |
| BUZZER1 | 板载有源蜂鸣器 TMB12A05（C96093，12mm 直插，电磁式 2.4kHz） | 1=5V、2=BUZZ_N；外壳开声孔；建议再跨一颗 1N4148 续流 |
| LED1 + U12 | 电源指示灯：5mm 翠绿 LED（C52034719）+ 470Ω 0805（C2907329） | VCC → U12 → LED1 → GND，常亮（约 2.5mA） |
| U11 | 外接报警灯模块座：1×3 排针 LAIL-PM2.54-3P-L（C54973828） | 1=5V、2=GND、3=LED_CTRL（**顺序按模块丝印核对**） |
| DC1 | 已放 | **12V 电池输入 DC 座 DC-005-5.5×2.1（DC5521，C9900017044）** | 1 脚=12V_IN、2 脚=GND、3 脚（开关脚）留空；外壳需开孔 |

### 9.4 画图顺序建议

1. **先放机械件定坐标**：两个 START 板母座（按 7.3 的坐标，第 1 脚在下端）、J1、J2、K1、OLED 座、W5500 座；
2. **再放功率链**：F1 → D1 → R1 → K1，走线宽度按 2A 留余量（1oz 铜建议 2mm 以上）；
3. **放采样支路**：R2/R3 从 R1 焊盘内侧引出，接 U3 输入，C3/C4/C5 紧贴 U3；
4. **放电源**：U1 及外围、U2，注意 SW 节点面积最小；
5. **放驱动**：Q1/Q2 及基极电阻、续流二极管 D2；
6. **最后连信号**：I2C1、SPI1、GPIO、UART，全部用**网络标号**连接，不拉长线；
7. **逐条对照第八章网表核对**，重点核 GND 是否有遗漏。

## 十、位号对照表（本文档 ↔ 嘉立创 EDA 实际）

> **为什么需要这张表**：嘉立创 EDA 按器件放置的先后顺序自动编号，与本文档按电路功能
> 自定义的位号**不一致**（例如本文档的 U1 = MP1584，EDA 里 MP1584 是 U2，而 EDA 的 U1 是 INA228）。
> PCB 布局、贴片 BOM、飞线检查一律以 **EDA 的位号为准**，本文档的位号只用于阅读。

### 10.1 有源器件与接插件

| 本文档 | EDA 实际 | 器件 | 本文档 | EDA 实际 | 器件 |
|---|---|---|---|---|---|
| U1 | **U2** | MP1584EN 降压 | U2 | **U3** | AMS1117-3.3 |
| U3 | **U1** | INA228 | K1 | **RLY1** | SRD-05VDC-SL-C |
| L1 | **U4** | 47µH 电感 | Q1 / Q2 | Q1 / Q2 | SS8050 |
| D1 | D1 | SS54 防反接 | D2 | **D3** | 1N4148 续流 |
| D3 | **D2** | SS34 DC-DC 续流 | F1 | F1 | PTC |
| J1 / J2 | **U7 / U8** | 24V 端子 / 负载端子 | JP6 / JP5 | **U5 / U6** | 2×19 母座 |
| OLED 座 | **H1** | 1×4 | W5500 座 | **U9** | 1×7（**缺 GND 脚**） |
| 串口座 | **U10** | 1×3 | NTC 座 | **H2** | 1×2 |
| 报警灯座 | — | **尚未放置** | 蜂鸣器座 | — | **尚未放置** |

### 10.2 电阻

| 本文档 | EDA 实际 | 数值与用途 |
|---|---|---|
| R1 | R1 | 2mΩ 分流 |
| R2 / R3 | R2 / R3 | 10Ω INA228 输入串阻 |
| R4 / R5 | R11 / R12 | 4.7kΩ I2C 上拉 |
| R6 | R14 | 1kΩ 继电器基极限流 |
| R8 | R13 | 1kΩ 蜂鸣器基极限流 |
| R7 | R6 | 10kΩ 继电器基极下拉 |
| R9 | R5 | 10kΩ 蜂鸣器基极下拉 |
| R10 | R4 | 10kΩ NTC 分压上臂 |
| R11 | R7 | 100kΩ FB 上臂 |
| R14 | R8 | 100kΩ FREQ |
| R15 | R9 | 100kΩ EN 上拉 |
| R12 | R15 | 19.1kΩ FB 下臂（决定 5V 值） |
| R13 | R10 | 6.8kΩ COMP |

### 10.3 电容

| 本文档 | EDA 实际 | 数值与用途 |
|---|---|---|
| C1 / C2 | C10 / C11 | 10µF/50V 输入 / 输出滤波 |
| C3 | C4 | 100nF 差分滤波 |
| C4 / C5 | C5 / C6 | 10nF 共模滤波 |
| C6 | C2 | 100nF INA228 去耦 |
| C7 / C8 | C7 / C8 | 10µF/25V LDO 输入 / 输出 |
| C9 | C1 | 100nF BST |
| C10 | C9 | 3.3nF COMP |
| C11 | C3 | 100nF NTC 滤波 |
