liu369369/contest2026_443_fengxieke/hardware/pcb_layout_routing_rules.md

# 火眼载板 · 排版与布线规则 v1.0

> 日期：2026-10-12
> 适用对象：火眼载板（105 × 140 mm，2 层板）
> 配套文档：`fireeye_carrier_board_design.md`（设计/网表）、`easyeda_progress.md`（工程现状与踩坑）
> 用途：布局与布线时逐条对照执行；每完成一个网络按第十二章自检。

---

## 一、三条总原则（其它规则都从这里派生）

1. **一切服从"采样精度"**。INA228 的电流测量是本作品的卖点，凡与它冲突的（走线、器件位置、铺铜），一律让路。
2. **先关键、后一般**。关键网络（采样、开关环路、24V 功率）先走并占通道；慢速信号最后走，可以绕远、可以打孔。
3. **铺铜永远最后做**。先铺铜再走线会导致"处处绕不开"，这是最常见的返工原因。

---

## 二、工艺底线（嘉立创常规双面板，成本/周期最优）

| 项目 | 工艺能力 | 本板采用 | 说明 |
|---|---|---|---|
| 最小线宽 | 0.127 mm（5 mil） | **≥0.2 mm（8 mil）** | 留 1.5 倍余量，更好焊、更抗工艺波动 |
| 最小线距 | 0.127 mm | **≥0.2 mm** | 功率对信号 ≥0.5 mm |
| 最小机械孔 | 0.3 mm | **0.3 mm** | 过孔孔壁 |
| 最小孔环 | 0.13 mm | **0.15 mm** 以上 | 0.3/0.6 mm 过孔=孔环 0.15 mm ✓ |
| 铜到板边 | ≥0.25 mm | **≥0.5 mm** | 外形铣边公差大，留足 |
| 板厚 | — | **1.6 mm** | 标准 |
| 铜厚 | — | **1 oz（35 µm）** | 1.75 A 用 1 oz + 1.5 mm 线宽已足够 |
| 阻焊桥 | ≥0.2 mm | 默认 | 不手动改 |
| 表面处理 | — | 有铅喷锡 / 无铅喷锡 | 手焊选喷锡最省事 |

**结论：本板全部使用常规工艺，打样没有任何"加钱项"，也不需要特殊说明。**

---

## 三、层叠与分工（2 层板）

```
顶层 Top     ：所有走线 + 器件 + 补铺 GND（开关电源区开挖）
底层 Bottom  ：少量短跳线 + 整片 GND 铺铜（关键区下方必须完整）
```

**为什么不上 4 层**：本板只有 17 条要连的信号、没有板级高速差分（W5500 的以太网差分对在模块内部）、只有 4 个电源且都能铺铜解决。4 层换来的性能，对本板真正的瓶颈（采样前端、地平面完整度）没有帮助，却要贵 3~5 倍、慢 2~3 天。

**什么时候才值得上 4 层**：板上要跑 USB/以太网差分对、需要阻抗控制、或需要独立的 5V/3.3V 电源平面。

---

## 四、线宽表（含计算依据）

依据 IPC-2221（外层走线、1 oz 铜、允许温升 10 °C）：

```
A[mm²] = ( I / (k · ΔT^0.44) )^(1/0.725)，外层 k = 0.048
w[mm]  = A / 0.035（1 oz 铜厚）
```

| 网络 | 实际电流 | 计算最小宽度 | **本板采用** | 备注 |
|---|---|---|---|---|
| 24V 功率链`U7→F1→D1→R1→继电器→U8` | 1.75 A | ≈0.78 mm | **1.5 mm（60 mil）** | 余量约 2 倍；空间允许可到 2 mm |
| 继电器线圈`5V→线圈→Q1`、`RELAY_COIL_N` | 0.071 A | ≈0.05 mm | **0.75 mm（30 mil）** | 感性回路，宽一点更稳 |
| `SW_NODE`（U2 SW→电感→续流） | 0.3 A | ≈0.15 mm | **0.75~1.5 mm（30~60 mil）** | **铜面积越小越好**，宽是为了环路阻抗低 |
| `12V_IN`（DC 座→C10/R9/U2-VIN） | 0.16 A | ≈0.1 mm | **0.75 mm（30 mil）** | |
| `5V` 分配 | 0.25 A | ≈0.13 mm | **0.65 mm（25 mil）** | 到 AMS1117 输入的分支可 20 mil |
| `VCC`（3V3）分配 | 0.15 A | ≈0.1 mm | **0.4 mm（16 mil）** | |
| 采样差分对 `INA_INP/INM` | 2.5 nA | 工艺下限 | **0.2 mm（8 mil）线宽 + 0.2 mm 线距** | 不载流，看的是抗干扰 |
| 一般信号（I2C/SPI/UART/GPIO/NTC_ADC） | — | — | **0.2 mm（8 mil）** | 批量统一，省心 |
| GND | — | — | **不画线，走铺铜** | 通孔焊盘用热焊盘 + 缝合过孔 |

**注意**：这里的线宽都偏保守（远超计算下限），代价只是占地方；**唯一不能细的是功率链**。

---

## 五、间距规则

| 情况 | 最小间距 | 本板采用 |
|---|---|---|
| 信号 ↔ 信号 | 0.2 mm | 0.2 mm |
| 信号 ↔ 5V/3V3 | 0.2 mm | 0.3 mm |
| 信号 ↔ 12V/24V | 0.5 mm | 0.5 mm |
| 差分对内部（两根之间） | — | **固定 0.2 mm**（全程一致） |
| 差分对 ↔ 其他网络 | 1 mm | ≥1 mm |
| `SW_NODE` ↔ 其他 | 0.5 mm | 0.5 mm |
| 铺铜 ↔ 信号 | 0.3 mm | 0.3 mm（12 mil） |
| 铺铜 ↔ 12V/24V | 0.5 mm | 0.5 mm（20 mil） |
| 过孔 ↔ 异网络走线/焊盘 | 0.2 mm | 0.3 mm |

---

## 六、过孔规则

| 项 | 规定 |
|---|---|
| 尺寸 | **0.3 mm 孔 / 0.6 mm 盘**（12/24 mil），常规工艺不加钱；不做 0.2 mm 孔（贵）|
| 大电流过孔 | 1.75 A 路径换层时 **≥2~3 个并联**，或孔径加大到 0.5 mm |
| 位置 | **不得打在焊盘上**（需要"盘中孔"工艺，加钱）✗；不要压在丝印文字上 ✗ |
| 缝合过孔 | GND 双面连通，间距 **≤5 mm**；每个去耦电容旁各 1 个地过孔 |
| 换层原则 | 过孔 = 两层都要接上：换层后**必须在该层继续走线到目的地**，或直接扎进铜皮（接平面时）✗ 只打一半 = 断头孔 |

**可以打孔的网络** ✓：`GND`、`5V`、`VCC`、`12V_IN`、`24V_*`（多打几个）、`UART_*`、`SPI1_*`、`W5500_*`、`RELAY_*`、`BUZZ_*`、`LED_CTRL`、`NTC_ADC`、`I2C1_*`（尽量少）。

**尽量别打孔的网络** ✗：

| 网络 | 原因 |
|---|---|
| `INA_INP` / `INA_INM` | 打孔破坏等长对称与最小环路；**非打不可时两根一起、同一位置对称打** ✗ 绝不能只打一根 |
| `SW_NODE` | 每多一个过孔多一份寄生电感，是整板最敏感节点 |
| `BST_NODE` | 同上（自举节点） |

---

## 七、转角、走线形态与通用规则

1. **转角一律 45° 折角或圆弧**；禁止直角、禁止锐角 ✗（蚀刻残留 + 阻抗突变 + 锐角处线宽变细）；
2. **差分对折角必须两根同步对称**，否则破坏等长；
3. **不走"锐角分叉"**（T 形分叉尽量形成 90° 或 45° 的规整分叉）；
4. **避免长距离平行走线**（串扰）：不同网络平行长度尽量 <20 mm，必要时拉开间距或加地线隔离；
5. **环路面积最小化**：凡是"信号去 + 回流回来"的路径，都尽量让两条路径贴在一起（差分对、去耦电容、开关环路都遵循这条）；
6. **禁止"孤岛走线"**：每段线必须属于某个网络的连通块，不允许零长度或悬空线段（已出现过 `24V_P(2343,304)-(2343,304)` 这类废线段，走完必须清）；
7. **同一网络优先单层走完**；必须换层时按第六章规则。

---

## 八、关键网络专项规则（本板的重点，逐条对照）

### 8.1 采样链路（决定精度，最优先）

1. **开尔文取样**：`INA228` 的 IN+/IN− 只从 `R1`（2 mΩ）**焊盘内侧**引出，不借用功率走线；
2. **差分对**：`R3→U1 IN+`、`R2→U1 IN−` 两根 **并排、等长、同层、线距固定 0.2 mm**；
3. **从两侧分别进脚**：`U1` 的 IN+/IN− 是相邻脚（0.5 mm 脚距），一根从左进、一根从右进，否则必然挤在一起 ✗；
4. **滤波件贴输入脚**：`R2/R3`（10 Ω）、`C4`（100 nF 差分）、`C5/C6`（10 nF 共模）全部在 `U1` 输入脚 **3 mm 内**；`C4` 横跨两根线，`C5/C6` 各自分叉；
5. **地单独回**：`C5-1/C6-1` 的地**单独引回 `U1` 的 GND 脚**，不得就近接铺铜 ✗；
6. **避让**：差分对与 `SW 节点 / 电感 / 继电器线圈回路` 距离 ≥5 mm，且不平行；`U1` 的 VBUS 是直流采样，长一点无妨，可以就近接 `24V_SW`。

### 8.2 开关电源环路（EMI 的源头）

1. **环路面积最小**：`C10(输入电容) → U2(MP1584) → U4(电感) → C11(输出电容) → 回 GND` 这条回路要尽可能小；
2. **输入电容紧贴芯片**：C10 到 U2 的 VIN/GND 走线 ≤3 mm；
3. **SW 节点铜面积最小**：`U2-SW → U4 → D2` 这段线短、粗（30~60 mil）、不引长线、不扇形铺铜；
4. **敏感小网络紧贴芯片**：`BST(C1)`、`COMP(C9+R10)`、`FB(R7+R15)`、`EN(R9)`、`FREQ(R8)` 全部走线 ≤10 mm；
5. **FB / COMP 走线下方不铺铜**（或在铺铜时开挖），避免寄生电容影响环路稳定；
6. **续流二极管 D2 紧贴电感和 SW 节点**，回路最短。

### 8.3 24V 功率链

1. 顺序固定：`U7 → F1 → D1 → R1 → 继电器 COM(3) → NO(2) → U8`，线宽 **60 mil**；
2. **尽量走直、走短**；继电器与分流电阻的距离建议 **20~25 mm**（既不太远导致大环路，也不太近让线圈噪声靠近采样）；
3. 大电流路径**贴板边走**，不要横穿板中间 ✗，不要与 I2C/SPI/采样差分对平行 ✗；
4. 45° 折角，不与继电器触点/线圈的走线并行。

### 8.4 继电器驱动与线圈

1. `Q1`、`R14`（1k 基极）、`R6`（10k 下拉）、`D3`（1N4148 续流）**紧贴继电器线圈侧**；
2. 续流二极管 `D3` **跨在线圈两端**（阴极接 5V、阳极接 `RELAY_COIL_N`），引脚到线圈走线尽量短；
3. 线圈回流的 `GND` 与采样地**分开走**，不穿过采样区。

### 8.5 I2C / SPI

1. `I2C1_SCL/SDA`：上拉 `R11/R12`（4.7 k 到 3.3 V）就近放在总线一端；两根线尽量并排走；**别和 SW、电感、线圈并行**；
2. `SPI1_*` 与 `W5500_*`：从母座 → 网口座走短路径；不跨地平面分割缝；必要时串 22~33 Ω 抑制振铃；
3. 两者都**允许打过孔换层**（慢速总线不要求等长），但换层后必须两层都接上。

### 8.6 地（GND）

1. **底层整片 GND**，采样区（`R1` + `U1` + `R2/R3/C4/C5/C6`）**正下方必须完整**，不得被异网络走线/过孔切碎 ✗；
2. 顶层补铺 GND，但 `SW 节点周围`、`FB/COMP 走线下方`开挖；
3. 通孔焊盘接铜皮一律**热焊盘**；
4. 双面地用**缝合过孔**连通（≤5 mm）；
5. 大电流回流（继电器线圈、负载回流）走各自最短路径，**不与采样地共用一段**。

---

## 九、铺铜规则

| 项 | 规定 |
|---|---|
| 顺序 | **永远最后做** ✗ 先铺后走线 = 处处绕不开 |
| 底层 | **整片 GND**（本板底层目前无走线，是理想状态，尽量保持） |
| 顶层 | 补铺 GND；开关电源区剔除 |
| 开挖区（keepout） | ① `SW` 节点及电感周边 ② `FB`/`COMP` 走线下方 ③ 天线/无关区域（本板无） |
| 热焊盘 | 通孔焊盘用 thermal relief；气隙 0.3~0.5 mm、连接条 0.3~0.5 mm、连接条数 4 |
| 孤岛 | 勾选"移除孤岛"，避免无连接的碎铜 |
| 间距 | 铺铜到信号 0.3 mm；到 12V/24V 0.5 mm |
| 缝合过孔 | 间距 ≤5 mm；每个去耦电容旁 1 个 |
| VCC 铜岛 | AMS1117（U3）散热脚是 **VOUT（3.3V）**，其 4 个散热过孔要扎进 **VCC 铜岛**，不能扎进地 ✗ |

**铺铜验收标准**：跑一次连通性检查，**GND 应从 30 块变成 1 块** ✓。

---

## 十、布局规则

1. **按功能分区**：功率区（输入端子/保险丝/防反接/分流/继电器/负载端子）、采样区、电源区（DC-DC/LDO）、数字区（母座/网口/OLED/蜂鸣器/LED）、接口区；
2. **按连接关系摆件**：互相连线的器件放近、**引脚朝向对方**（这是减少交叉最有效的办法）；
3. **同一个网络的器件成簇**：开关电源的外围件贴芯片、去耦电容贴电源脚、基极电阻贴三极管、限流电阻贴 LED；
4. **大件靠边、接口件朝板边**：OLED 座、网口座、DC 座、端子、蜂鸣器、LED 都朝外壳面板/开孔那一侧；
5. **通孔高件不得放在 START 板覆盖区下方**（板下净空只有 8.5 mm）；贴片件 ≤2 mm 可以；
6. **板框内留边距**：四周 ≥5 mm（本板 105×140，母座按设计文档机械坐标，不可随意移动）；
7. **丝印**：接口件标注（`24V IN`/`LOAD OUT`/`12V BAT`/`SERIAL`/`OLED`/`W5500`/`NTC`/`ALARM LED`/`BUZZER`/`PWR LED`/`START-JP6`/`START-JP5`）+ 测试点标注（`5V`/`FB`/`3V3`/`GND`）；丝印**不压焊盘**；
8. **测试点**：`5V`/`FB`/`3V3`/`GND` 各一个（φ1.5 mm 焊盘），便于调机探针；
9. **散热**：AMS1117 散热脚下铜 + 过孔；发热件（MP1584/电感/AMS1117）不挤在一起；外壳在该区域开通风孔；
10. **器件间距**：0603 器件中心距 ≥4.3 mm（本体 2 mm + 两侧余量），0805/1206/SOT-223/SOIC-8 按本体尺寸加大；大件（继电器 19.2×15.6、模块 28×55）按本体尺寸单独检查，不能只算焊盘。

---

## 十一、自检与验收

### 11.1 每完成一个网络 → 跑四项检查

1. **异网焊盘间距**：每段线到所有异网络焊盘的最小距离 ≥30 mil（0.76 mm；U1 相邻脚 0.5 mm 脚距造成的 19~20 mil 告警属固有，可忽略）；
2. **同网共线重叠**：同一网络的横线/竖线不得重叠（重复线段 = 废线，要删）；
3. **异网 T/X 交叉**：不同网络的两段线不得形成 T 形/X 形交点（= 短路）；
4. **越界**：所有走线/过孔/器件必须在板框内。

### 11.2 每完成一档 → 跑连通性检查

按网络统计"焊盘 + 走线 + 过孔"的连通块数：**每个功能网络应只有 1 块**（`GND` 铺铜后 1 块；母座上位号标记的单点网络 1 块属正常）。

### 11.3 出板前（三项）

1. `pcb_Drc.check()` 通过；
2. 与原理图逐网络对照（17 条信号 + 电源网络全部连通、无短路）；
3. 丝印不压焊盘；板框闭合；无零长度废线。

### 11.4 上电前人工确认（五项，板上无法自动判断）

1. **DC 座极性**：万用表通断档量中心孔对应哪个焊盘（现按 1 脚 = 12V_IN、2 脚 = GND；3 脚开关脚留空）；
2. **网口模块**：1 脚（3.3 V）与 2 脚（5 V）都接着，确认模块是否自带 LDO（带的话建议断开 1 脚）；
3. **报警灯模块座 U11** 顺序：现接 1=GND、2=5V、3=LED_CTRL，按模块丝印核对；
4. **蜂鸣器极性**：现接 1=5V、2=BUZZ_N（接反只会不响）；
5. **5V 分压 R15（19.1 k）在位**：决定 5V 输出值，缺了会失控。

---

## 十二、已踩过的坑（照此避开，别再花时间）

| # | 坑 | 现象 | 正确做法 |
|---|---|---|---|
| 1 | 先铺铜后走线 | "根本绕不开" | 铺铜永远最后 |
| 2 | 直角走线 | 不规范 | 45° 折角/圆弧 |
| 3 | 差分对从两个相邻脚中间穿 | 线距只剩 8 mil（等于压线） | 一根从左进、一根从右进 |
| 4 | 只给差分对一根打过孔 | 破坏对称 | 要打就两根同位置一起 |
| 5 | 过孔只打一半 | 断头孔、DRC 报未连接 | 换层后底层必须继续走线 |
| 6 | 器件朝向与链路相反 | 功率链要折返、必压焊盘 | 先确认输入/输出朝向（本板 F1/D1/R1 已各转 180°）|
| 7 | 端子两脚横向排列 | 从 VIN 往右走会撞到 GND 脚 | 先往左绕出去（U7 案例）|
| 8 | 继电器 COM 与 NC 同行、空脚挡路 | COM 无法从左进 | COM 只能从右侧绕进 |
| 9 | 以为"两列焊盘对称"就不用管哪列是 1 脚 | 信号整体错位 | 对照 START 板丝印确认 1 脚列位 |
| 10 | 用脚号当网络标签 | 两颗母座同号脚被连成 23 个网络 | 用 MCU 引脚名（PA1/PC13…）标注空脚 |
| 11 | 元件移动后导线不跟随 | "标签还在、连接已断"，DRC 抓不到 | 每轮移动后跑连通性检查 |
| 12 | API 改网络名返回成功但没生效 | 静默失效（59 条里 30 条） | 改完必须读回校验 |
| 13 | 零长度废线段 | `(2343,304)-(2343,304)` | 走完清理 |
| 14 | 只看焊盘算间距 | 器件本体压在一起（模块/继电器） | 大件按本体尺寸单独检查 |
| 15 | 0.5 mm 脚距的 IC 触发"间距告警" | 假告警 | 相邻脚 19~20 mil 属固有，可忽略 |

---

## 十三、布线顺序清单（可直接照做）

| 档 | 顺序 | 网络 | 线宽 |
|---|---|---|---|
| 0 | — | **先删掉铺铜** | — |
| 1 | 采样（最优先） | `INA_INP`/`INA_INM`、`C5/C6→U1 GND`、`R1→R3/R2` 开尔文支路 | 8~10 mil |
| 2 | 开关环路 | `12V_IN→C10→U2-VIN`、`SW_NODE`、`D2`、`BST/COMP/FB/EN/FREQ` | 8~60 mil |
| 3 | 电源主干 | `24V` 链、线圈回路、`5V`、`VCC` | 60/30/25/16 mil |
| 4 | 驱动 | `RELAY_CTRL/DRV/COIL_N`、`BUZZ_CTRL/DRV/N`、`LED_CTRL`、`$1N239` | 8 mil |
| 5 | 慢速信号 | `NTC_ADC` → `I2C` → `SPI`+`W5500_*` → `UART` | 8 mil |
| 6 | 收尾 | 铺铜 → 泪滴 → 四项检查 + 连通性 + DRC | — |

---

*本文档与 `fireeye_carrier_board_design.md`（设计）配合使用：设计文档回答"接什么"，本文档回答"怎么摆、怎么走、怎么验"。*
