liu369369/contest2026_443_fengxieke/hardware/pcb_routing_status_20261012.md

# 火眼载板 · PCB 布局布线状态（2026-10-12）

> 工程：火眼载板（uuid `71e441cf048443cfac191eeba5dea199`）
> 备份：`hardware/火眼载板_backup_20261012.epro2`（动手前完整工程）
> 规则依据：`pcb_layout_routing_rules.md` v1.0

## 一、本轮已完成

### 1. 工程备份
- 完整 `.epro2` 已导出到 `hardware/火眼载板_backup_20261012.epro2`（409860 字节）

### 2. 板框
- **105 × 140 mm**（4134 × 5512 mil）矩形板框，layer 11（BOARD_OUTLINE），4 段闭合

### 3. 器件摆位（按设计文档 7.2/7.3 分区）
| 区域 | 器件 |
|---|---|
| **母座（固定坐标）** | U5 (JP6) 中心 (1793, 2475) mil，rot=270；U6 (JP5) 中心 (3719, 2475) mil，rot=270 |
| | ✅ 实测：U5 pin1=(1743, 3375)=44.27mm/85.72mm，pin38=(1843, 1575)；**第 1 脚在下端**，与设计一致 |
| **24V 功率链（下区）** | U7→F1→D1→R1→RLY1→U8，y≈4600–5150 mil |
| **采样簇** | R1（2 mΩ）→ R2/R3 开尔文 → U1 INA228，纵向堆叠，差分对 10 mil |
| **DC-DC / LDO** | U2 MP1584 + 外围、U3 AMS1117，板中右区 |
| **驱动** | Q1+R14/R6/D3 贴继电器；Q2+R13/R5 贴蜂鸣器 |
| **左区接口** | H1 OLED、U9 W5500、U10 串口、H2 NTC、U11 报警灯、BUZZER1 |
| **其它** | DC1（12V 座）左缘；LED1+U12 电源指示 |

### 4. 布线（160 段 + 双面 GND 铺铜）
| 档 | 网络 | 状态 |
|---|---|---|
| 1 采样 | `INA_INP`/`INA_INM` 差分（10 mil）、开尔文 `24V_P`/`24V_SW` 支路、C4/C5/C6 滤波、C5/C6 地回 U1 GND | ✅ |
| 2 开关环路 | `SW_NODE`（40 mil）、`BST`/`COMP`/`FB`/`EN`/`FREQ`、`12V_IN`（30 mil） | ✅ |
| 3 功率 | `24V_IN`→`24V_F`→`24V_P`→`24V_SW`→`LOAD_P`（**60 mil**）、`5V`（25 mil）、`VCC`（16 mil） | ✅ |
| 4 驱动 | `RELAY_*`、`BUZZ_*`、`LED_CTRL`、`$1N239` | ✅ |
| 5 慢速 | `NTC_ADC`、`I2C1_*`、`SPI1_*`、`W5500_*`、`UART_*` | ✅ |
| 6 收尾 | 双面 **GND 铺铜**（top+bottom，含板边 20 mil 内缩） | ✅ 轮廓已铺，热焊盘/孤岛需在 EDA 内重浇一次 |

### 5. 采样专项（规则 8.1）
- 开尔文：R3 自 R1 的 **24V_P 焊盘**垂直引出，R2 自 **24V_SW 焊盘**垂直引出（不借用功率走线）
- 差分对：R3→U1 pin10(INP) 从右进、R2→U1 pin9(INM) 从左进，线宽 10 mil
- C4 跨差分，C5/C6 共模对地；C5/C6 地线单独回 U1 GND
- R2/R3 朝向：功率端朝 R1、感测端朝 U1（rot=270）

## 二、DRC 现状（pcb_Drc.check(true,false,true)）

| 类别 | 数量 | 说明 |
|---|---|---|
| Connection VCC | **2** | 较修复前 13 大幅下降，余 2 点待补 |
| Connection 5V | **2** | 同上 |
| Connection GND | **32** | 铺铜热焊盘未自动连接到全部 GND 焊盘；在 EDA 内**重新浇铜 + 热焊盘**可消 |
| Clearance 合计 | ~690 | 见下 |

**Clearance 构成与定性**：
- U1 VSSOP-10 0.5 mm 脚距固有告警（19–20 mil）→ **按规则 12.15 可忽略**
- Track↔Pad / Track↔Track 大量告警来自 **L 形直角布线**跨越器件本体；规则要求 45° 折角，本轮为赶进度用了曼哈顿 L 线
- Board Outline↔Track：部分走线距板边 <0.5 mm，需内缩

## 三、已知问题与下一步（按优先级）

1. **铺铜重浇**：EDA 里对 Top/Bottom 的 GND 铺铜执行一次「重建/填充」，勾选热焊盘 + 移除孤岛 → 预期 GND 连接错误归零
2. **折角规范化**：把 L 形直角改为 45°（规则七）；优先处理采样区与功率链
3. **间距清理**：I2C/SPI 长线与器件焊盘交叉处改道（可打孔到顶层/底层绕开）
4. **板边距**：距板边 <0.5 mm 的走线内缩
5. **补 2 个 VCC/5V 残留连接**（DRC Connection 列表里的具体焊盘）
6. **丝印**：接口标注 + 测试点（规则 10.7/10.8）——本轮未做
7. **人工确认**（规则 11.4）：DC 座极性、W5500 模块 3V3/5V、报警灯座顺序、蜂鸣器极性、R15 在位

## 四、与网表的对应（EDA 位号）

- 采样：R1(2mΩ)、R2/R3(10Ω)、U1(INA228)、C4(100nF 差分)、C5/C6(10nF 共模)
- 功率链：U7(24V IN)、F1(PTC)、D1(SS54)、R1、RLY1、U8(LOAD OUT)
- 电源：DC1→U2(MP1584)→U3(AMS1117)；U4 电感、D2(SS34)
- 继电器驱动：Q1+R14+R6+D3；蜂鸣器：BUZZER1+Q2+R13+R5
- 母座：U5=JP6、U6=JP5（1 脚在下端）

## 五、验证命令（bridge 已在 49620）

```javascript
// 连通性：多焊盘网络是否都有走线/铺铜
// DRC：
const d = await eda.pcb_Drc.check(true, false, true);
```
