liu369369/contest2026_443_fengxieke/docs/submit_checklist.md

# 提交检查清单（截止 9/20）

> 更新：2026-09-18 20:35 ｜ 口径依据 `drafts/火眼_事实边界.md`、版本依据 `固件版本沿革.md`。
> 状态：✅ 完成 ／ 🟡 进行中 ／ ❌ 未完成

## 一、官方要求的 6 项

| # | 项目 | 状态 | 现状与缺口 | 下一步（谁做）|
|---|---|---|---|---|
| 1 | 作品代码进专属仓 + PR 合入 | 🟡 | 已本地提交 `b3e0bf4`（78 文件：应用诊断命令、defconfig、nuttx/vendor 补丁、文档口径、README 已知限制、自建 Skill、日志）；**尚未 push / 建 PR** | push 到 fork 并建 PR → 合入（主会话 push，用户点合入）|
| 2 | README.md（含已知限制）| ✅ | 名称/赛道/运行方式/简介齐全；已把板端存证改为上位机留痕口径，并新增「已知限制」6 条（存证未跑通、漏电/断网补传未实现、电流读数量级、过流等效注入、W5500 现状、看门狗）| 无需再做 |
| 3 | 作品介绍文档 | 🟡 | docx 已按实测改口径（芯片 3MB、存证受限、架构图「事件留痕」框已重绘）；**但群里明确要求用官方模板（3.1–3.7 逐项填写，勿自换格式）**，现有 docx 是自制结构 | 用户从官网下载模板 → 主会话按模板重排/补全 → 导 PDF |
| 4 | 演示视频（≤5 分钟）| ❌ | `docs/演示脚本.md` 已更新到当前真机状态（5V 风扇、上电不转/运行转、报警断电、上位机留痕分镜、诚实口径）| 用户按脚本开录 → 主会话可帮校字幕与时长 |
| 5 | AI Coding 日志 | ✅ | 统一口径重导 **56 个会话**（08-12 ~ 09-18）写入 `logs/liu369369/`，manifest 更新，`validate-log.py` **✅ ALL OK**（4564 条事件）；密钥扫描 0 命中 | 随代码一起 push 即可 |
| 6 | 线上传播（加分）| ❌ | 三条文案定稿（`drafts/线上传播文案_定稿.md`：B站/知乎/朋友圈）| 用户发布 3 条 → 回填链接到本文件 |
| 7 | 项目内自建 Skill | ✅ | 新增 `.claude/skills/fireeye-board-debug/SKILL.md`（构建/烧录/上板自检/硬件事实/常见问题）| 无需再做 |

## 二、公共仓改动（组委会 review，不自行 merge）

| 仓库 | 状态 | 下一步 |
|---|---|---|
| `open-vela/nuttx` PR #383 | 🟡 等 review | 本次新增：progmem 区域改到 0x08080000、写入流程改为"先编程→复位缓存→再校验" → push 到 fork 分支 `fireeye-gd32f407` 更新 PR |
| `open-vela/vendor_gigadevice` PR #7 | 🟡 等 review | 本次新增：defconfig（关闭板端存证、继电器极性、上电默认吸合）→ 同上 |

## 三、材料口径要点（所有材料必须符合）

1. **芯片**：GD32F407VK，**3MB Flash**（实测 `FMC_SIZE=3072KB`）、SRAM 192KB、168MHz；配置里曾误写 1MB（VG），已纠正。
2. **继电器**：**高电平触发**，负载接 COM + NC；上电（未运行 fireeye）继电器吸合、负载断电；运行后进入 NORMAL 才供电；报警吸合断电。
3. **电流**：ACS712-30A + 10k/10k 分压进 PA4；1 个 ADC 码 ≈ 0.024 A；负载是 **5V 风扇（铭牌 0.15 A）**；实测读数在 0.1~0.2 A 量级（含继电器线圈耦合的残余偏移）；过流演示用**等效电压注入**并如实说明。
4. **板端存证**：设计完成但**本板未跑通**（同一扇区同一 4KB 页内只有个别地址可编程），演示固件已关闭；**报警事件留痕由上位机承担**——`tools/fireeye_monitor.py` 把事件与报警前后 30 条采样写入 `tools/data/fireeye_events.jsonl`（已实现并测试）。
6. **AI 能力**：判定层是可解释的滤波/阈值/趋势算法（离线可用）；研判层用大赛 MiMo 模型（OpenAI 兼容接口，模型 mimo-v2.5，Bearer 鉴权）在上位机对报警事件生成中文研判，后台线程调用、失败自动降级；端侧神经网络模型（TinyML）未实现，属扩展。
7. **未实现**（必须写成"扩展/后续"）：漏电监测、断网补传、RTC/NTP 对时、CAN/RS485 联动、TinyML、看门狗。

## 四、提交前最后自检

- [ ] `git status` 干净、`git log` 有本轮提交、`logs/liu369369/<日期>/` 已更新
- [ ] 官方仓能看到本轮 PR（或已合入）
- [ ] 作品介绍 docx 已导出 PDF 并打开确认排版
- [ ] 演示视频 mp4 / 1080p / 时长 ≤ 5:00，关键数字有字幕，过流段有"等效注入"说明
- [ ] 线上传播 3 条已发布（链接回填到本文件）

## 五、GitHub 使用要求（原清单保留）

- 全程使用账号 `liu369369`（报名时的账号）；
- 首次 PR 前在官网签 CLA（openvela.com → 社区 CLA）；PR 会自动跑 `cla/signature`；
- 目录约定：作品代码 `app/`、AI 日志 `logs/<github_login>/<date>/<tool>__<sid>.jsonl`、`README.md`。
