liu369369/contest2026_443_fengxieke/docs/接线图_电流检测.png

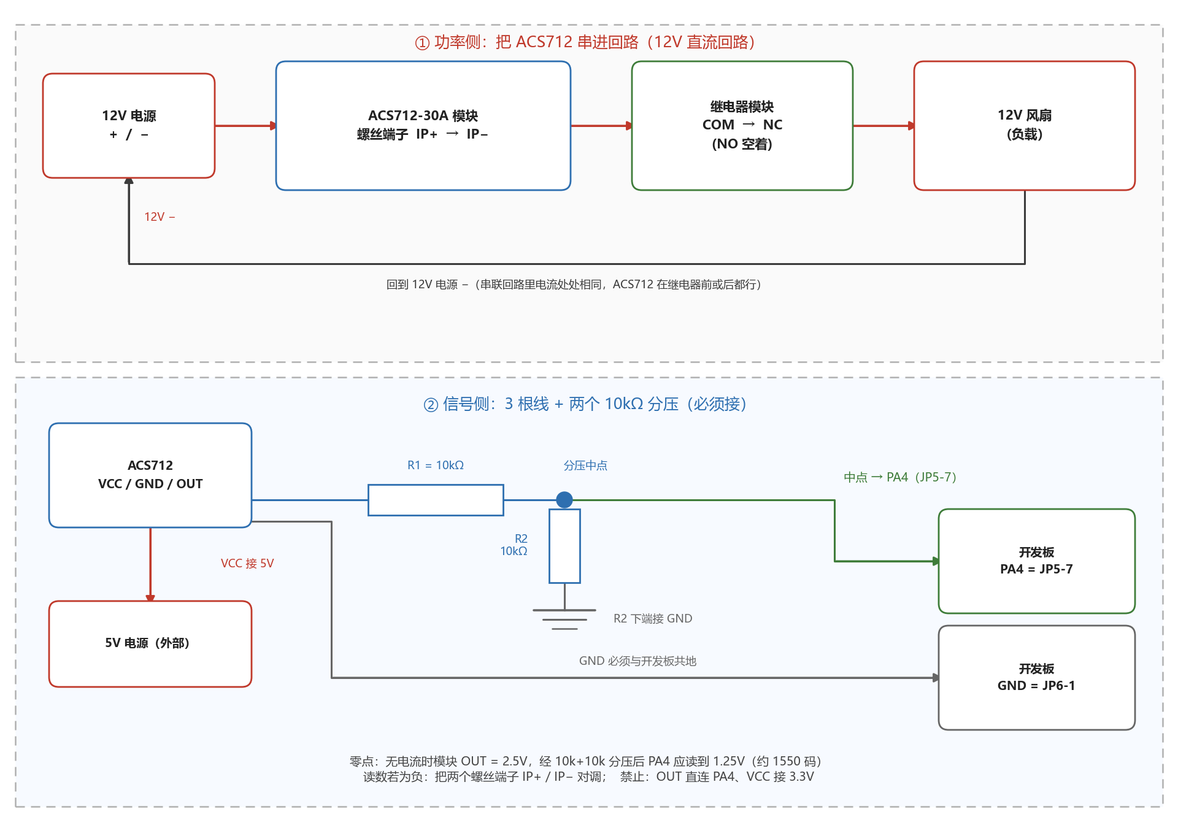
docs/接线图_电流检测.png
