liu369369/contest2026_443_fengxieke/docs/火眼接线图.png

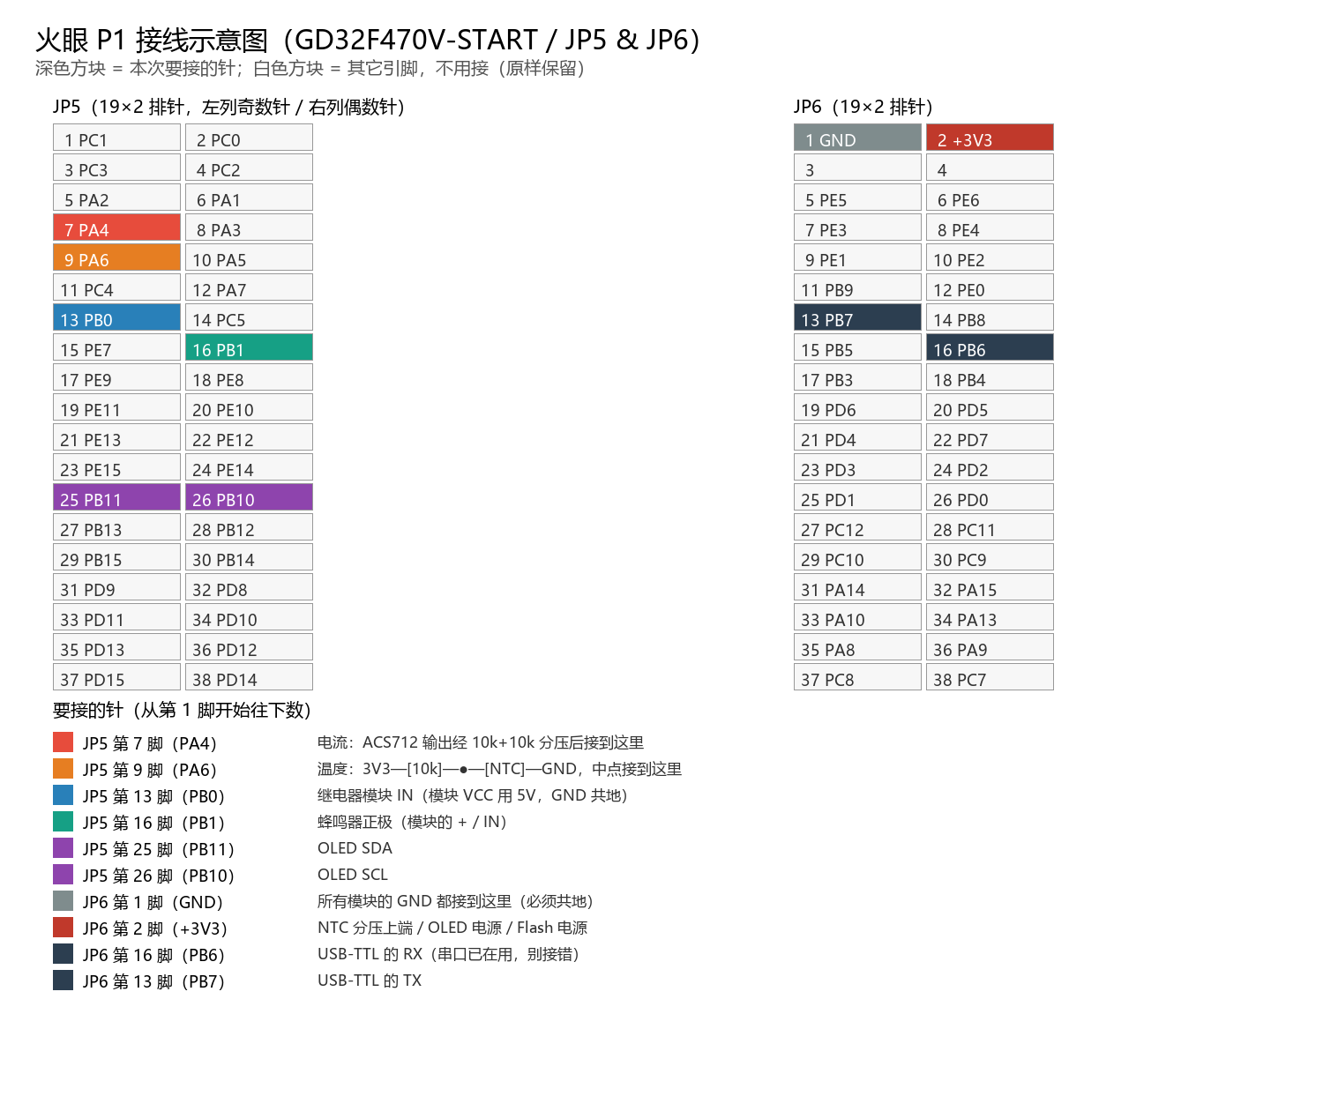
docs/火眼接线图.png
