liu369369/contest2026_443_fengxieke/hardware/enclosure/_check_assembly.stl

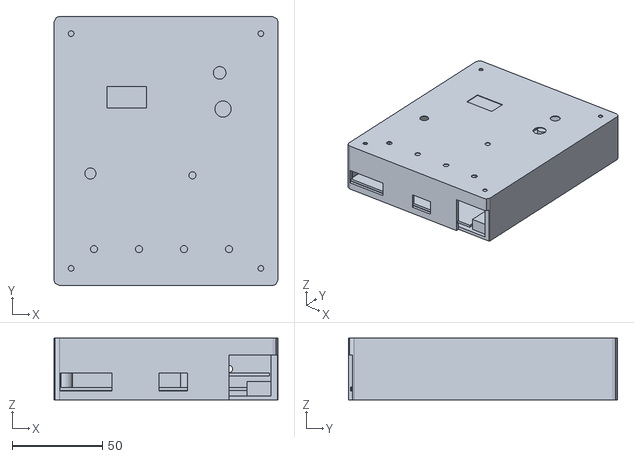
[picture p3: CAD file, 2026-10-15]
hardware/enclosure/_check_assembly.stl
124.4 x 149.4 x 34.4
