liu369369/contest2026_443_fengxieke/hardware/enclosure/_check_front.stl

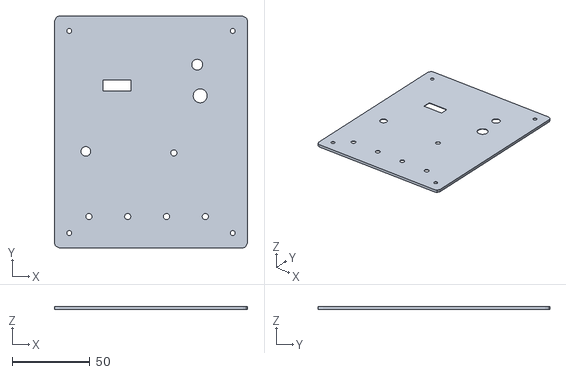
[picture p4: CAD file, 2026-10-15]
hardware/enclosure/_check_front.stl
124.4 x 149.4 x 2.20
