liu369369/contest2026_443_fengxieke/hardware/enclosure/top_shell_v4.stl

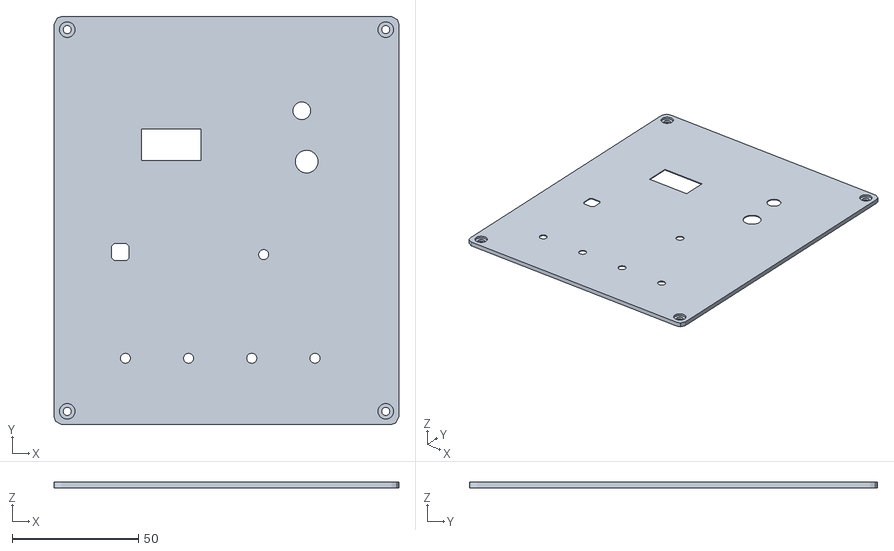
[picture p5: CAD file, 2026-10-15]
hardware/enclosure/top_shell_v4.stl
136.4 x 161.4 x 2.20
