liu369369/contest2026_443_fengxieke/hardware/enclosure/top_shell.stl

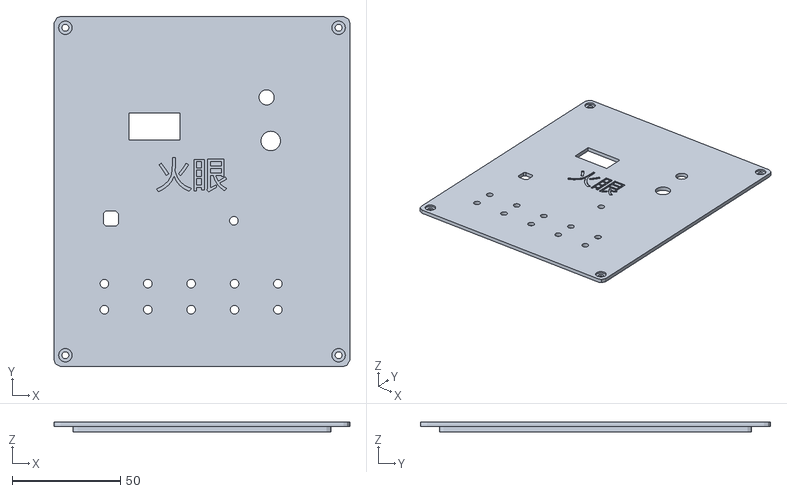
[picture p6: CAD file, 2026-10-15]
hardware/enclosure/top_shell.stl
136.4 x 161.4 x 4.70
