liu369369/contest2026_443_fengxieke/hardware/enclosure/bottom_shell.stl

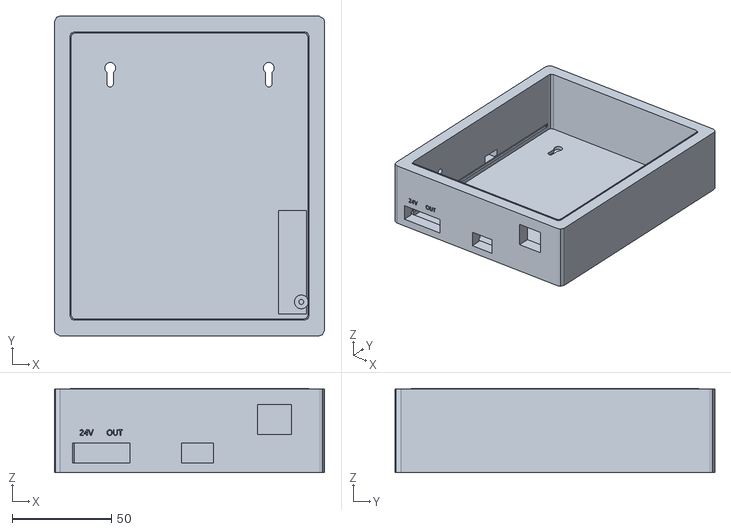
[picture p7: CAD file, 2026-10-15]
hardware/enclosure/bottom_shell.stl
136.4 x 161.4 x 42.6
