liu369369/contest2026_443_fengxieke/(commit log)

2026-09-03 chore: configure repo per submission guide
    - README: replace template with project intro (FireEye charging safety monitor)
    - remove unused quickapp/ and board/ sample skeletons + manifest links
    - logs: init logs/liu369369 with manifest, drop example sessions
    - docs: clean submit checklist (UTF-8)
2026-09-13 docs: add dev collaboration guide for teammates
    - add docs/development_guide.md: env setup, hardware wiring, algorithm
    prototype, schedule W1-W4, AI log & submission flow
    - README: add collaboration entry link
2026-09-13 docs: add AGENTS.md and CLAUDE.md for agent collaboration
    AI agents auto-load these at repo root, so teammates using Codex / Cursor /
    Claude Code get project conventions automatically (env, hardware, algorithm,
    submission flow, AI log spec).
2026-09-13 build: integrate FireEye into openvela build tree
    - manifest: add app/fireeye linkfile to packages/demos; fireeye_prototype is a PC-side Python reference, not linked into the build
    - CMakeLists: drop INCLUDES param (src/include resolves relative to source), keep nuttx_add_application with NAME/STACKSIZE/PRIORITY/SRCS
    - Makefile/Make.defs: align CONFIGURED_APPS path with packages/demos convention
    - docs: add architecture_design.md and setup_guide.md
    [fireeye_config.h, fireeye_filter.c, fireeye_fsm.c, fireeye_main.c, fireeye_threshold.c]
2026-09-13 build: add lite manifest for fast local GD32 build
    contest2026_443_fengxieke_lite.xml keeps only the repos needed to build the
    GD32F470V-START target (nuttx, apps, packages, frameworks, build,
    vendor gigadevice/openvela, arm-none-eabi toolchain, build-tools, cmake, tools
    and the team repo). Drops emulators, other-platform toolchains, external third
    party libs and other vendor boards. Official grading still uses the full
    contest2026_443_fengxieke.xml.
2026-09-13 build: lite manifest v2 with shallow nuttx + toolchain
    Add clone-depth=1 to nuttx and prebuilts gcc arm-none-eabi so the local sync
    fetches only the latest commit, cutting nuttx from ~1M objects / multi-GB to
    ~200MB, which also avoids TLS drops on long transfers.
2026-09-13 build: lite manifest v3 - drop prebuilt arm toolchain
    The ~500MB prebuilt arm-none-eabi download keeps failing on the flaky network.
    Drop it from the local lite manifest; build will use the system gcc-arm-none-eabi
    (installed via apt) by linking it into the prebuilts path at build time.
2026-09-13 docs: project README, F407 adaptation record, fix fireeye Kconfig
    - README.md: replace template with works description (intro, track, structure, run, AI usage)
    - docs/adaptation_F407.md: record porting openvela to GD32F407 (chip dispatch, 25MHz/168MHz clock, build+flash, open issues)
    - app/fireeye/Kconfig: Kconfig does not support float type -> switch thresholds to int
2026-09-13 docs: submission materials - works intro, demo script, AI log
    - docs/作品介绍.md: full project intro (overview, problem, tech, structure, run, highlights)
    - docs/演示脚本.md: 5-min screen-recording script using the PC algorithm prototype
    - logs/liu369369/: AI Coding log (manifest + codex session jsonl)
2026-09-13 feat(fireeye): 接入真实传感器与报警执行器
    - 新增 fireeye_sensors 模块：ACS712 电流换算（分压 1/2、上电零点校准）、
    NTC(10K B3950) 温度换算（B 参数方程）、按键消抖、报警输出调度
    - fireeye_main：改为使用真实 ADC 采样；采样无效时保留上次有效值并标记，
    OLED 显示 --；去掉采样失败回退模拟数据、以及伪造漏电触发 ALARM 的旧逻辑
    - 新增 fireeye test 子命令：依次自检蜂鸣器(PB1)/继电器(PB0)/报警灯(PD9)
    - oled_display：修复初始化缓冲区越界导致电荷泵命令丢失（屏幕全黑）、
    补 msg.frequency（I2C 分频依赖它）、0x3C/0x3D 地址重试、刷新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
    [fireeye_config.h, fireeye_main.c, fireeye_sensors.c, oled_display.c]
2026-09-13 docs: 更新适配记录、开发板接线文档与作品材料
    - adaptation_F407.md：补充 P1 实机验证结果（串口/OLED/温度/电流/报警灯/蜂鸣器/继电器/按键）、
    以及实机定位到的 4 个驱动问题与修复
    - 新增 docs/开发板接线.md：JP5/JP6 引脚分配、分压电路、电源与共地、排错要点
    - 新增 docs/火眼接线图.png：排针与模块对应关系示意图
    - 作品介绍/演示脚本/README/AGENTS：同步实测结论（串口已通、时钟根因、I2C1 与 LED/KEY 引脚）
2026-09-13 chore: 归档 openvela 公共仓适配补丁
    把 WSL 构建树里 nuttx / vendor 的适配改动导出成补丁留档，避免 repo sync 后丢失：
    - nuttx：GD32F407 的 chip/pinmap/memorymap/progmem 分发与 CMakeLists
    - vendor/gigadevice：gd32f470v_start 板级（USART0 改 PB6/PB7、I2C1 引脚、
    168MHz/25MHz 晶振配置、火眼板级硬件模块与 LED 自检）
    公共仓改动需按大赛规则单独向组委会提 PR，见 patches/README.md。
2026-09-13 chore(logs): 导出 AI Coding 日志
    - 用 Codex 会话记录导出本项目相关的 9 个会话（2320 条记录）到
    logs/liu369369/<date>/codex__<session_id>.jsonl，并重建 manifest.json
    - 删除原先的 5 行模板占位日志
    - 导出时已脱敏：GitHub token / API key / Authorization 头替换为 ***REDACTED***
2026-09-13 fix(fireeye): 修正输出模块触发极性与电流零点校准
    - 输出极性按实机确认：继电器、蜂鸣器为低电平触发，报警灯为高电平触发
    （板级宏 FIREEYE_RELAY_ACTIVE_LOW / FIREEYE_BUZZER_ACTIVE_HIGH / FIREEYE_LED_ACTIVE_HIGH）
    - 电流零点改为"先断开负载再校准"：开机继电器吸合 0.5s 采样零点后恢复供电，
    避免把负载电流当成零点（此前现象：负载停转后读数变为 -0.16A）
    - 新增 fireeye level 命令：蜂鸣器/继电器/报警灯逐脚输出 LOW 2s、HIGH 2s，
    用于确认模块触发极性（不同批次模块极性不一致）
    - 文档：补充阈值实机触发验证（50℃ 预警、60℃ 报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
    [fireeye_main.c, fireeye_sensors.c]
2026-09-13 docs: 演示脚本改为真机版（分镜 + 旁白逐字稿）
    - 分镜按 4 分 30 秒编排：系统全貌 → 正常态 → 50℃/65℃ 触发预警与报警（含联动断电）
    → 过流等效电压注入 → 按键复位 → 新硬件适配亮点 → 收尾
    - 附录制前准备清单、拍摄设置、旁白逐字稿、剪辑要点与常见问题
    - 过流段明确标注"现场无大电流负载，用等效电压注入模拟"，避免夸大
    - 旧的 PC 端 Python 原型脚本内容由本文件替代，原型作为算法先行验证的补充素材
2026-09-16 feat(tools): 新增火眼上位机监控台（标准库实现，支持 --demo 自测）
    - 终端通过 HTTP POST JSON 上报，页面在浏览器查看（手机亦可）
    - 页面显示：当前状态/电流/温度、最近 5 分钟曲线、状态变化与报警事件列表、设备离线提示
    - 仅用 Python 标准库，无需 pip 安装；--demo 模式自带模拟数据便于先验证界面
    - 设备端上报地址 http://<PC_IP>:8080/api/data，配合网线直连的静态 IP 方案使用
2026-09-16 feat(fireeye): 接入 W5500 以太网 HTTP 上报
2026-09-16 logs: 同步 09-11 会话增量与 09-15 会话日志（已脱敏）
2026-09-16 chore(patches): 同步 2026-09-16 公共仓适配补丁（含 W5500 收包修复）
2026-09-16 logs: 追加 09-15 会话增量（密钥片段已脱敏）
2026-09-18 feat(fireeye): 板级诊断与口径收敛、AI 日志归集、上位机接入 MiMo 研判
    应用侧新增 fireeye store / fireeye adc 诊断命令，演示固件关闭板端存证（CONFIG_FIREYEYE_STORAGE 不使能）；板级 defconfig 改为继电器高电平触发、上电默认吸合；nuttx progmem 存储区改到 bank0 0x08080000 并在写入流程加入 flash 缓存复位；上位机接入大赛 MiMo 对报警事件生成中文研判（后台线程、失败降级）；新增自建 Skill .claude/skills/fireeye-board-debug；按官方 schema 与脱敏规则重导 56 个 AI 会话并清除残留令牌；README 已知限制与芯片口径修正、补充队伍信息。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
    [fireeye_main.c, fireeye_sensors.c, fireeye_storage.c]
2026-10-15 feat(hardware): 载板设计与 3D 打印外壳（OpenSCAD v4）
    - 载板设计文档：电路方案/网表/布局与布线规则/EDA 绘制进度
    - 嘉立创 EDA 工程备份（火眼载板_backup_20261012.epro2）
    - 参数化外壳 fireeye_enclosure_v4.scad：方案B边仓螺丝柱、四面卡槽、各接口开口、前盖压印「火眼」
    - 导出 STL（底壳 bottom_shell.stl / 前盖 top_shell.stl）与预览图
    - 外壳文档：重做任务书、设计规格、脚本修改清单
    - 历史版本 v3 / case / enclosure 一并留存备查
2026-10-15 chore: 修正 .gitignore（原为单行字面 \n，规则全部失效）并移除运行产物跟踪
